aiandrobotics/fabrica/specs/reference-images/fabrica-architecture.png

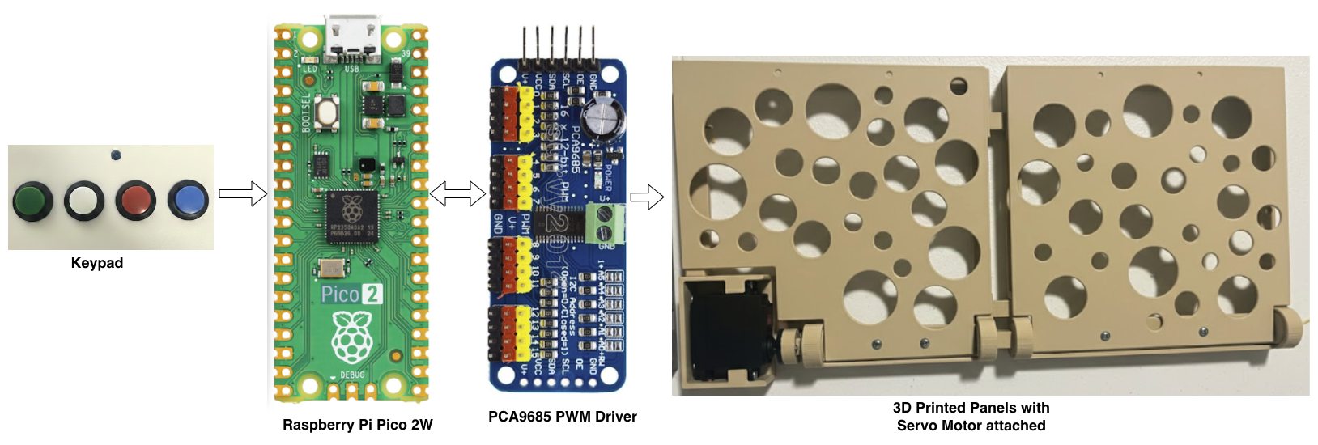
specs/reference-images/fabrica-architecture.png
