aiandrobotics/fabrica/specs/mission.md

# Fabrica - Cloth Folding Robot: Mission Specification

## Vision & Executive Summary

**Fabrica** is an open-source, end-to-end automated laundry folding system. The core mission of this project is to build and deliver a complete open-source hardware and software ecosystem—spanning **3D CAD designs**, **ESP32 firmware**, **a comprehensive documentation website**, and **a wireless mobile application**—that enables anyone to build, program, and operate a smart cloth folding robot for $80–$150.

Using a customizable grid of hinged 3D-printed panels and intelligent parallel servo motor actuation, Fabrica folds garments (such as t-shirts, towels, and trousers) in 8 to 12 seconds per item with a single button press or mobile app tap.

---

## Core Mission Deliverables

The Fabrica mission encompasses four primary, interconnected project deliverables:

1. **CAD Designs (`cad-designs/`)**:
   - Parametric 3D CAD models and STL/STEP export files for all modular panel types (Motorized, Follower, Base, Interface).
   - Engineered hinge linkages, drive shafts, servo couplers, and controller housing enclosures optimized for FDM 3D printing (PLA/PETG).

2. **Embedded Firmware (`firmware/`)**:
   - Production-grade C / FreeRTOS (ESP-IDF) firmware executing natively on the **ESP32**.
   - Driver integration for PCA9685 16-channel PWM servo driver over I2C, 4-button debounced interface, multi-pattern non-blocking status LED feedback, parallel and single motor step execution, non-volatile NVS flash sequence storage with IEEE 802.3 CRC32 protection, and factory default presets exercising all 4 folding flaps (Left, Right, Bottom, Top).

3. **Documentation Website (`docs/`)**:
   - A modern, interactive web-based documentation portal providing step-by-step 3D assembly guides, electrical wiring schematics, an interactive Bill of Materials (BOM), operation manuals, and troubleshooting flows.

4. **Mobile Application (`mobile-app/`)**:
   - The companion cross-platform mobile application is maintained in a dedicated external repository at **[https://github.com/aiandrobotics/air-robotics-app](https://github.com/aiandrobotics/air-robotics-app)**.
   - Provides wireless Bluetooth Low Energy (BLE) connectivity to the ESP32 firmware (`FAB0`–`FAB3` GATT services).
   - Enables visual sequence creation, button sequence configuration (Buttons 1–4), start/stop execution, real-time sequence progress and motor position monitoring, and client-side garment profile management.
   - The local `mobile-app/` directory serves as integration specifications, wire opcode documentation, and BLE protocol definitions.

---

## High-Level System Architecture

```mermaid
graph TD
    subgraph Deliverables Ecosystem
        CAD[CAD Designs<br/>cad-designs/]
        Docs[Docs Website<br/>docs/]
        Firmware[ESP32 Firmware<br/>firmware/]
        App[Mobile App<br/>mobile-app/]
    end

    User([User]) -->|Physical Buttons| Interface[Control Pad & LED]
    User -->|Wireless Control| App
    App -.->|Bluetooth LE (BLE)| Firmware
    Interface --> Firmware
    Firmware -->|I2C / PWM| Servos[Servo Motor Array]
    CAD -->|3D Printed Parts| Panels[Modular Panels & Frame]
    Servos --> Panels
    Docs -.->|Guides & Assembly| User
```

---

## Core Mission Pillars & System Goals

1. **Accessibility & Affordability**: Enable makers, STEM programs, and hobbyists to build a functional laundry robot for **$80–$150** using off-the-shelf components, standard 3D-printed parts, and affordable microcontrollers.
2. **Modular & Scalable Mechanical Design**: Support customizable grid arrangements (2×2, 4×3 standard, 4×4, 5×5, 6×6, or custom non-square layouts) supporting up to **16 motorized modules** paired with follower and base panels.
3. **Dual Operating Modes**: Standalone computer-free operation via physical button interface alongside full wireless control via the mobile application.
4. **Fluid Parallel Motion Execution**: Synchronized multi-motor execution allowing opposite panel flips to occur simultaneously, producing human-like motion and reducing cycle time by ~40%.
5. **Future AI Vision Expansion**: Camera-based fabric/garment vision recognition to automatically identify clothing types and suggest optimal folding parameters.

---

## Product Roadmap

- [x] **Deliverable 1: CAD Designs**: Modular 3D printed panel models, drive shafts, hinge links, controller housing, and full 4×3 grid assembly models.
- [x] **Deliverable 2: ESP32 Firmware (Core Engine & Presets)**: Embedded C/FreeRTOS firmware, PCA9685 I2C driver, 4-button debounced interface, status LED driver, parallel sequence executor, CRC32 NVS sequence manager, and 4 factory presets exercising all 4 flap motors (566/566 tests passing).
- [ ] **Deliverable 2b: Wireless BLE Mobile Integration**: Native NimBLE GATT services (`FAB1`, `FAB2`, `FAB3`), zero-bond indefinite auto-pairing & 120-second multi-device hold-to-pair window, and live telemetry.
- [ ] **Deliverable 3: Documentation Website**: Step-by-step mechanical assembly guides, wiring schematics, interactive BOM table, and user manuals.
- [ ] **Deliverable 4: Mobile Application**: Bluetooth Low Energy (BLE) wireless control, sequence configuration per button, start/stop execution, real-time motor progress streaming, and client-side garment profiles.
- [ ] **Future Expansion: AI Vision Recognition**: On-device or cloud-based AI garment classification from smartphone camera snapshot.

---

## Reference Visuals & Diagrams

The reference images located in [reference-images](./reference-images) document the system hardware, modules, and architecture:

- **System Overview & 3D Assembly**:
  - [3d-overview.png](./reference-images/3d-overview.png) - 3D CAD Overview of the assembled folding grid.
  - [fabrica-overview.png](./reference-images/fabrica-overview.png) - Assembled hardware unit overview.
  - [fabrica-architecture.png](./reference-images/fabrica-architecture.png) - Hardware and system architecture diagram.

- **Modular Components**:
  - [motorized-module.png](./reference-images/motorized-module.png) - Motorized module panel assembly with servo mount.
  - [follower-module.png](./reference-images/follower-module.png) - Passive follower hinged panel module.
  - [base-module.png](./reference-images/base-module.png) - Stationary structural base module.
  - [interface-module.png](./reference-images/interface-module.png) - Control pad and visual feedback interface module.

- **Controller**:
  - [rasberrypi-pico-2w.png](./reference-images/rasberrypi-pico-2w.png) - Microcontroller hardware reference.
