aiandrobotics/fabrica/specs/reference-images/3d-overview.png

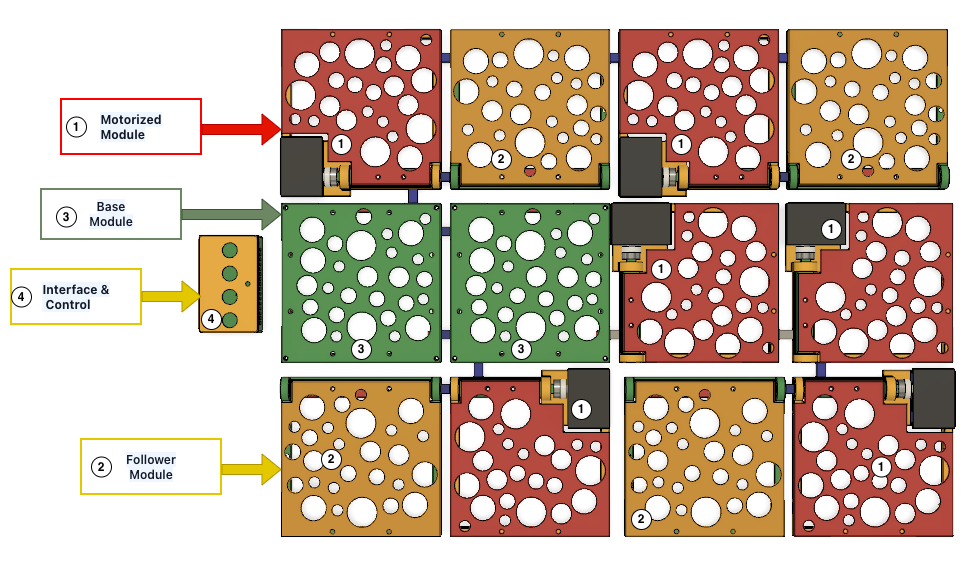
specs/reference-images/3d-overview.png
