aiandrobotics/fabrica/specs/reference-images/base-module.png

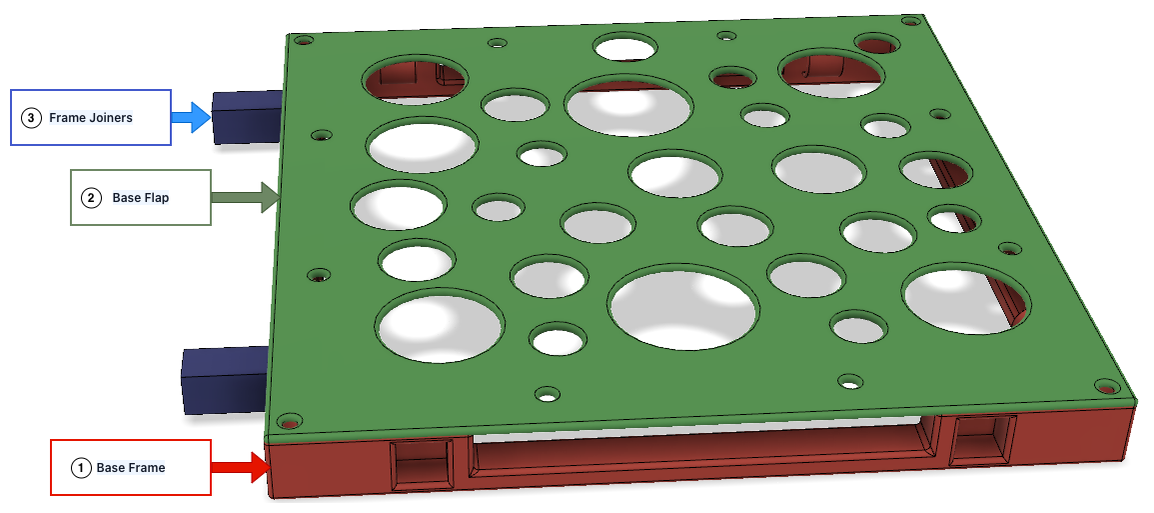
specs/reference-images/base-module.png
