aiandrobotics/fabrica/specs/reference-images/follower-module.png

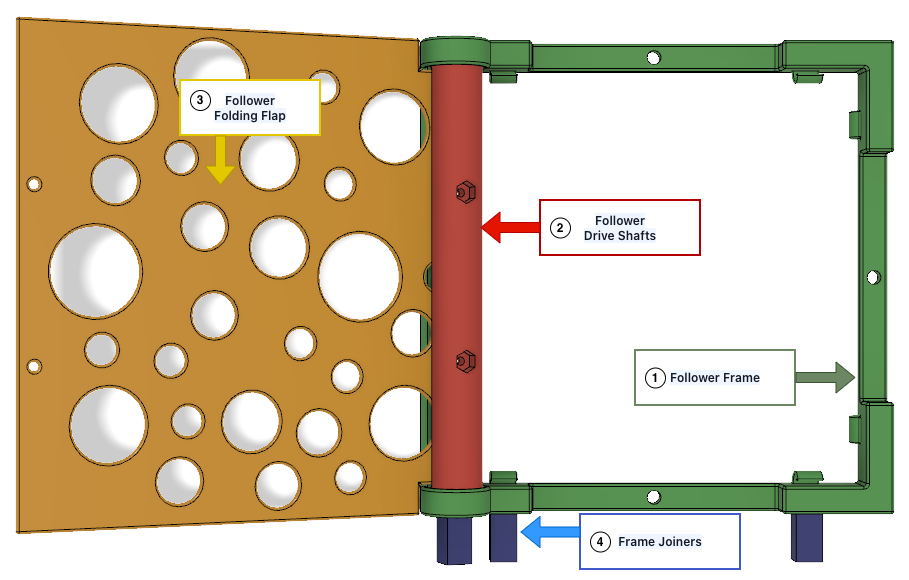
specs/reference-images/follower-module.png
