aiandrobotics/fabrica/specs/reference-images/interface-module.png

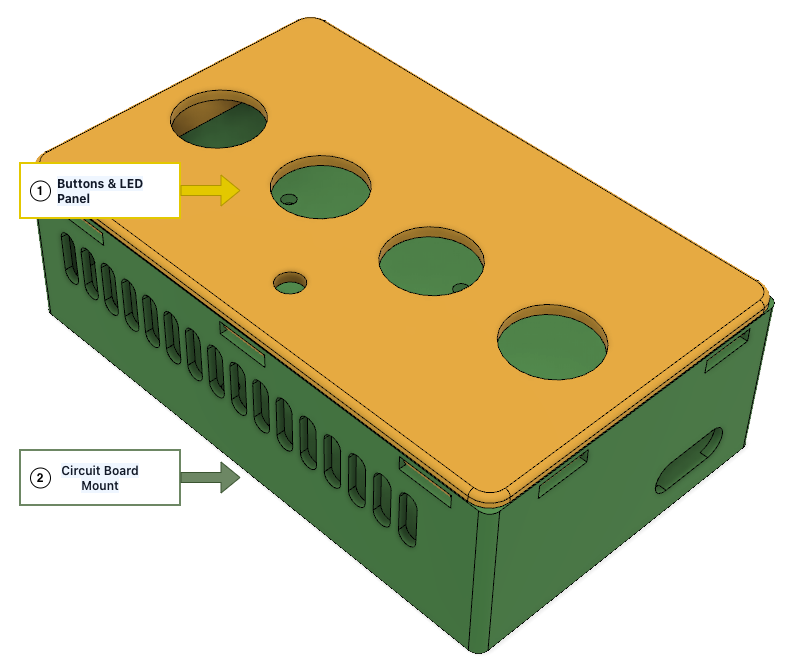
specs/reference-images/interface-module.png
