aiandrobotics/fabrica/specs/reference-images/mg996r-servo-dim.png

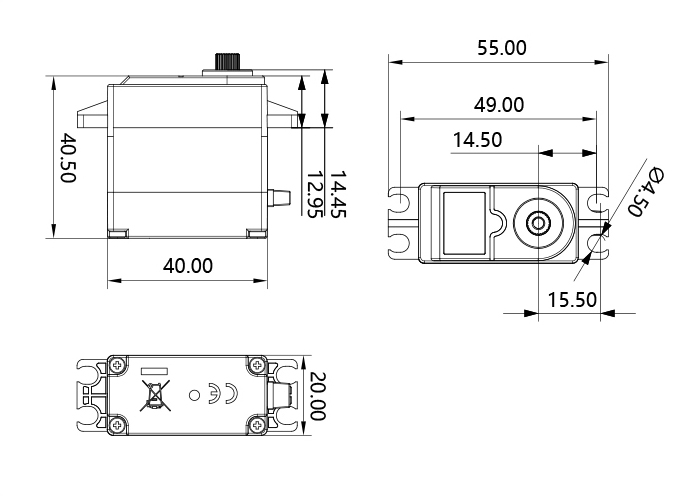
specs/reference-images/mg996r-servo-dim.png
