aiandrobotics/fabrica/specs/reference-images/mg996r-servo.png

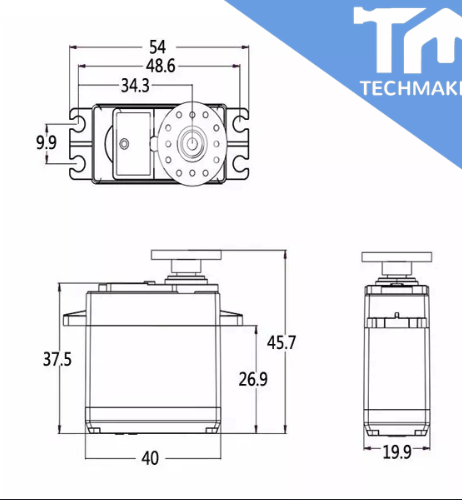
specs/reference-images/mg996r-servo.png
