aiandrobotics/fabrica/specs/reference-images/motorized-module.png

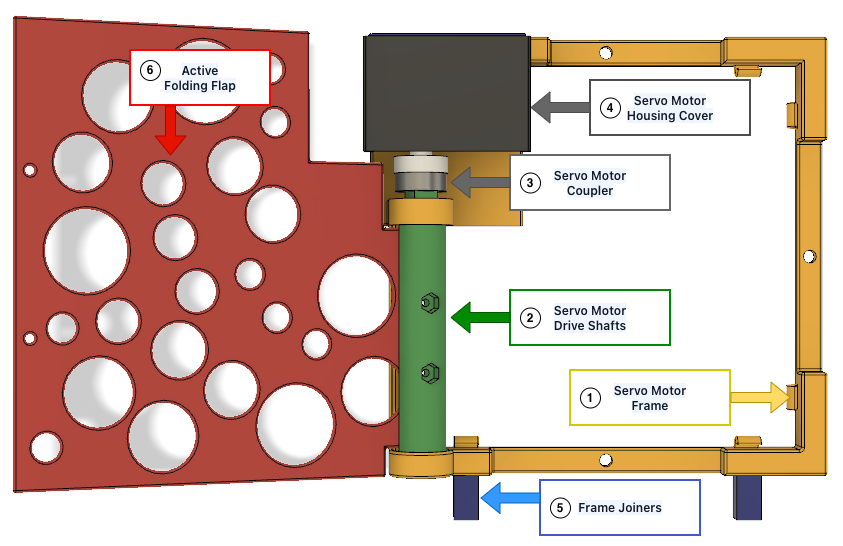
specs/reference-images/motorized-module.png
