aiandrobotics/fabrica/specs/reference-images/rasberrypi-pico-2w.png

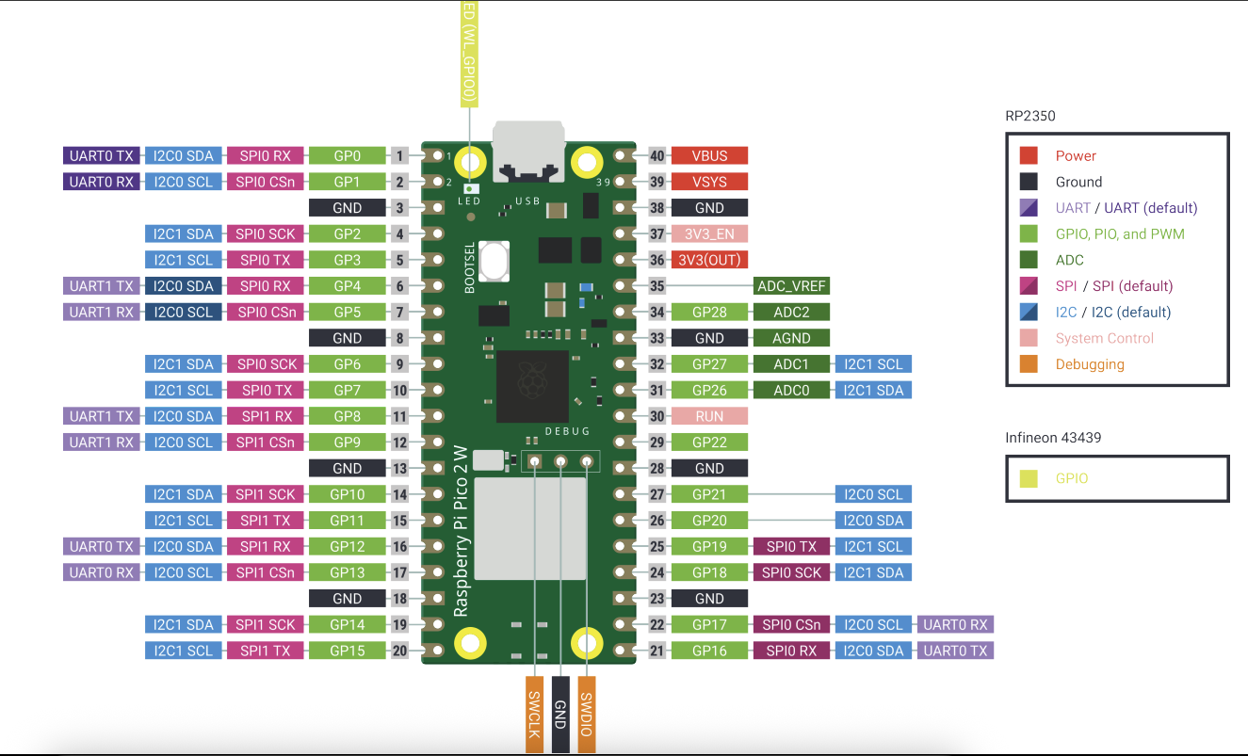
specs/reference-images/rasberrypi-pico-2w.png
