aiandrobotics/fabrica/cad-designs/exports/assembly.step

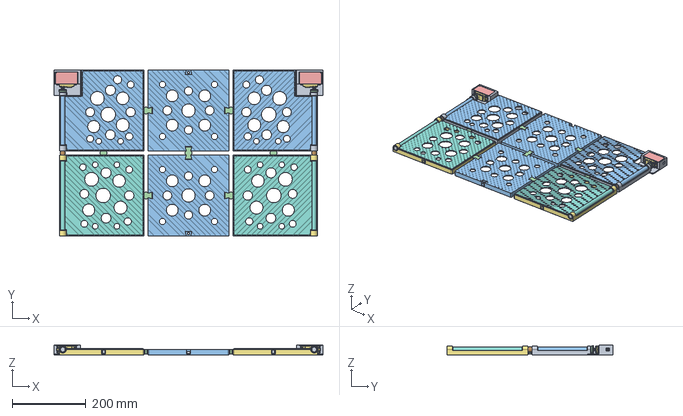
[picture p10: CAD file, 2026-11-06]
cad-designs/exports/assembly.step
728.0 x 450.0 x 27.2 mm
