aiandrobotics/fabrica/cad-designs/exports/follower_assembly.step

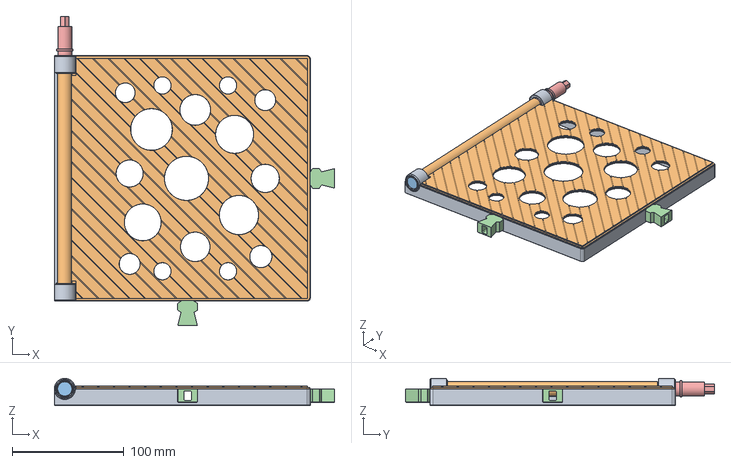
[picture p11: CAD file, 2026-11-06]
cad-designs/exports/follower_assembly.step
251.2 x 276.8 x 24.4 mm
