aiandrobotics/fabrica/cad-designs/exports/motorized_assembly.step

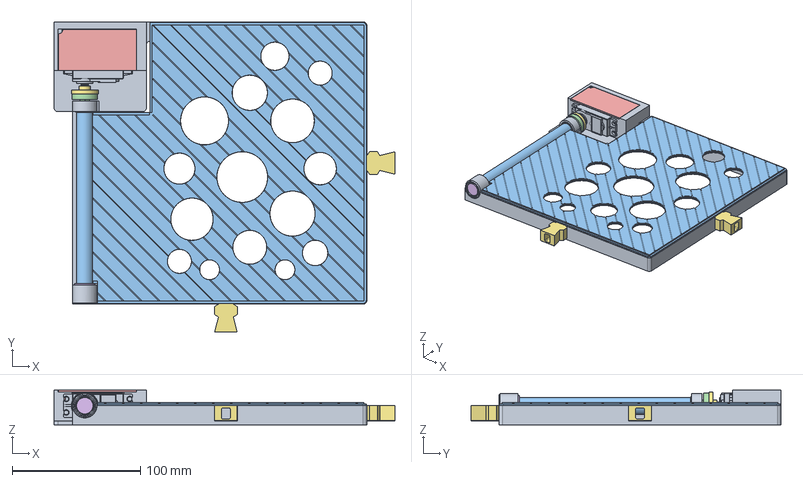
[picture p12: CAD file, 2026-11-06]
cad-designs/exports/motorized_assembly.step
265.8 x 241.8 x 27.2 mm
