aiandrobotics/fabrica/cad-designs/exports/interface_assembly.step

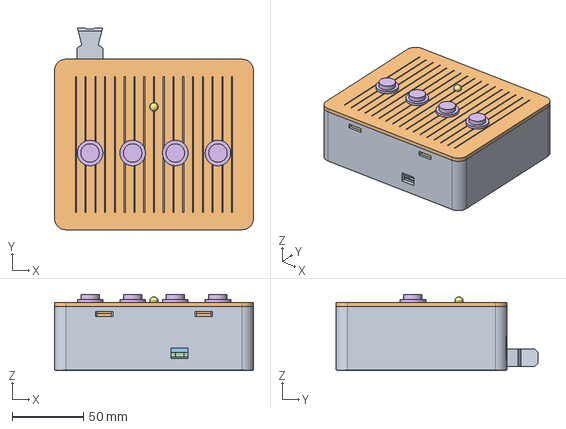
[picture p13: CAD file, 2026-11-06]
cad-designs/exports/interface_assembly.step
140.0 x 141.8 x 53.5 mm
