aiandrobotics/fabrica/cad-designs/3d-print/fabrica-bambu-lab-256.3mf

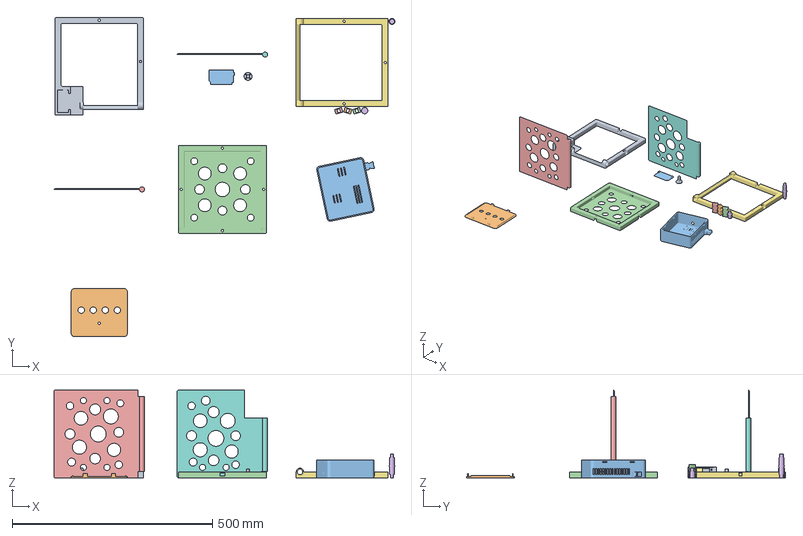
[picture p14: CAD file, 2026-11-08]
cad-designs/3d-print/fabrica-bambu-lab-256.3mf
850.5 x 796.4 x 219.0 mm
