aiandrobotics/fabrica/cad-designs/exports/motorized_servo_cover.step

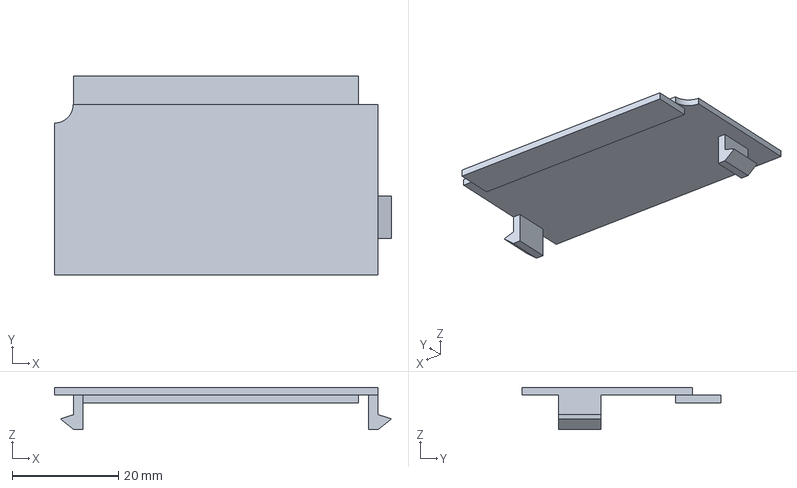
[picture p15: CAD file, 2026-11-06]
cad-designs/exports/motorized_servo_cover.step
63.3 x 37.3 x 7.90 mm
