aiandrobotics/fabrica/cad-designs/3d-print/MG996R.step

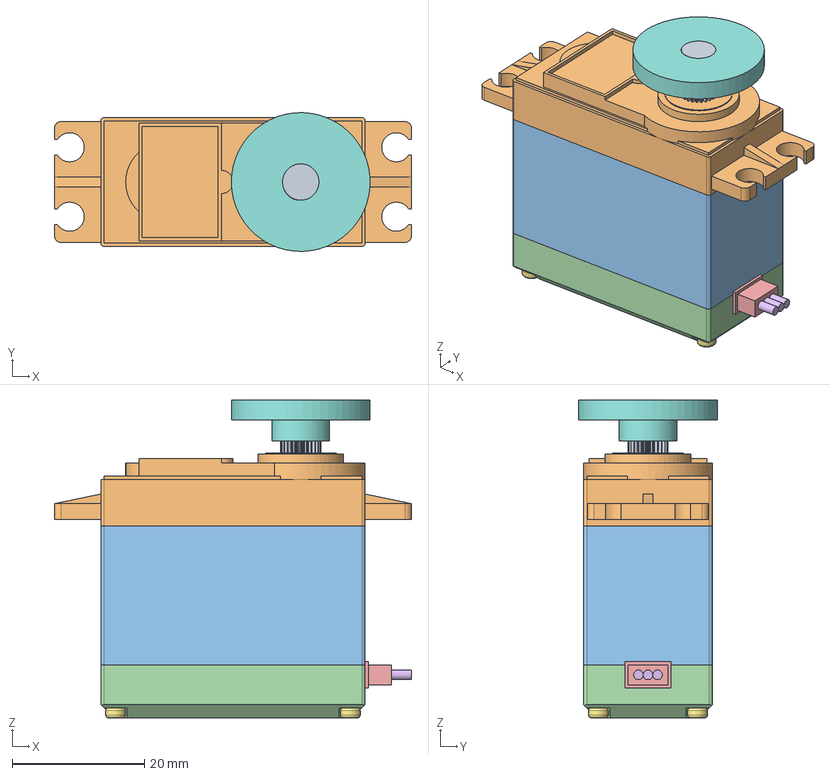
[picture p16: CAD file, 2026-08-18]
cad-designs/3d-print/MG996R.step
54.0 x 21.0 x 48.0 mm
Spur Gear (25 teeth)
mg996r-circular-connector
