aiandrobotics/fabrica/cad-designs/exports/interface_panel.step

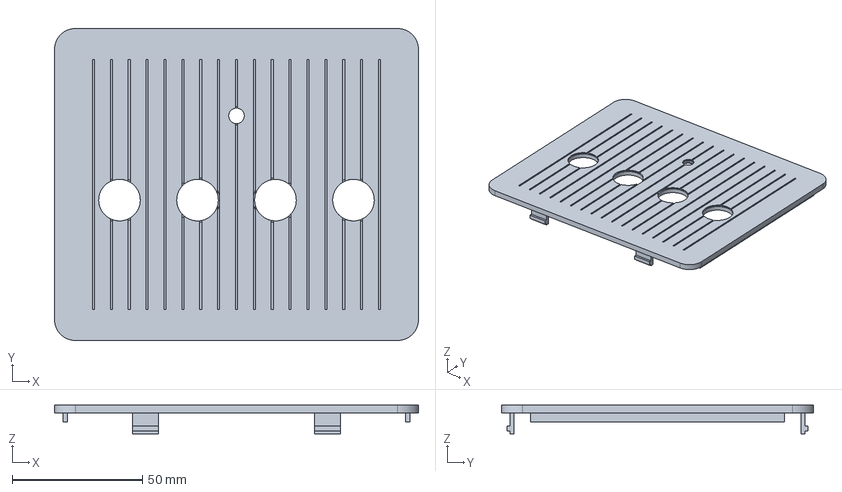
[picture p17: CAD file, 2026-11-06]
cad-designs/exports/interface_panel.step
140.0 x 120.0 x 11.0 mm
