aiandrobotics/fabrica/cad-designs/exports/interface_case.step

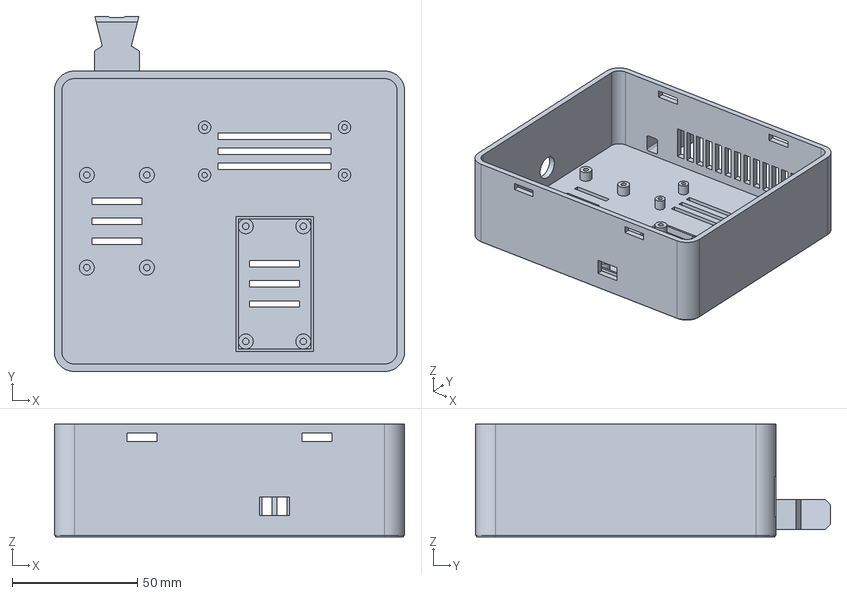
[picture p19: CAD file, 2026-11-06]
cad-designs/exports/interface_case.step
140.0 x 141.8 x 45.0 mm
