aiandrobotics/fabrica/cad-designs/exports/end_pivot_pin.step

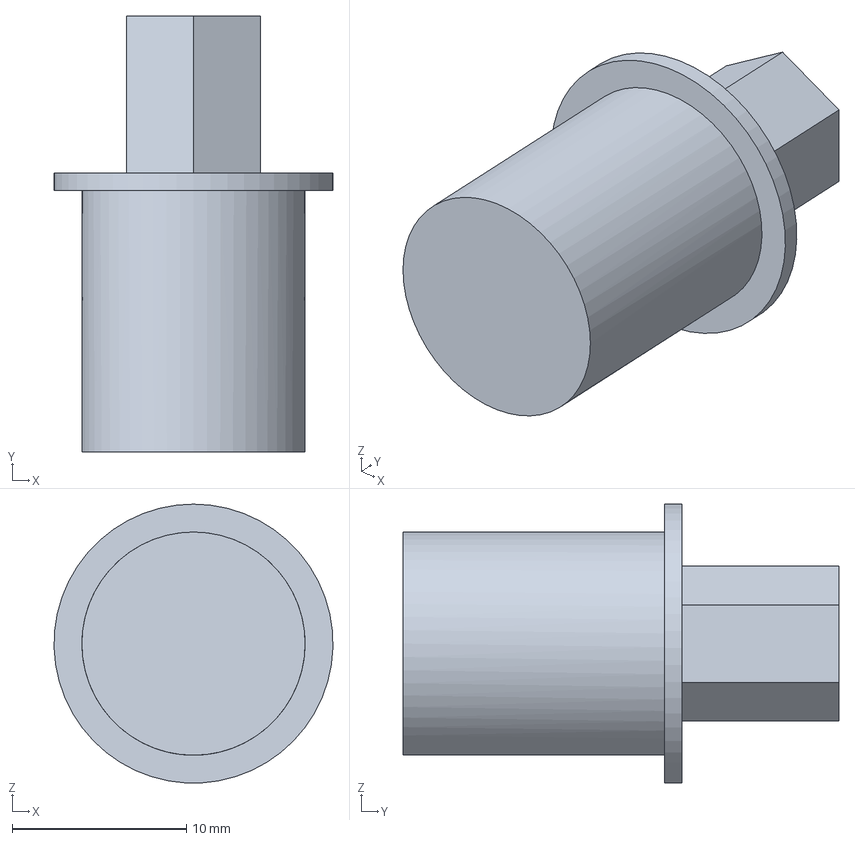
[picture p20: CAD file, 2026-11-06]
cad-designs/exports/end_pivot_pin.step
16.0 x 25.0 x 16.0 mm
