aiandrobotics/fabrica/cad-designs/exports/frame_joiner.step

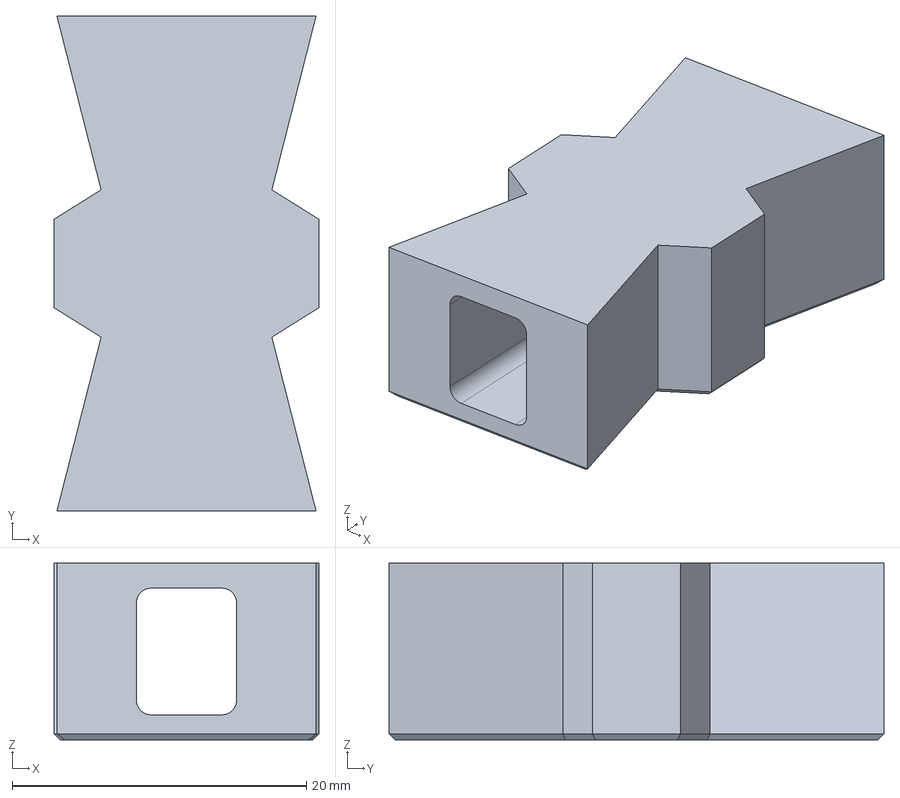
[picture p21: CAD file, 2026-11-06]
cad-designs/exports/frame_joiner.step
18.0 x 33.6 x 12.0 mm
