aiandrobotics/fabrica/cad-designs/exports/motorized_servo_adapter.step

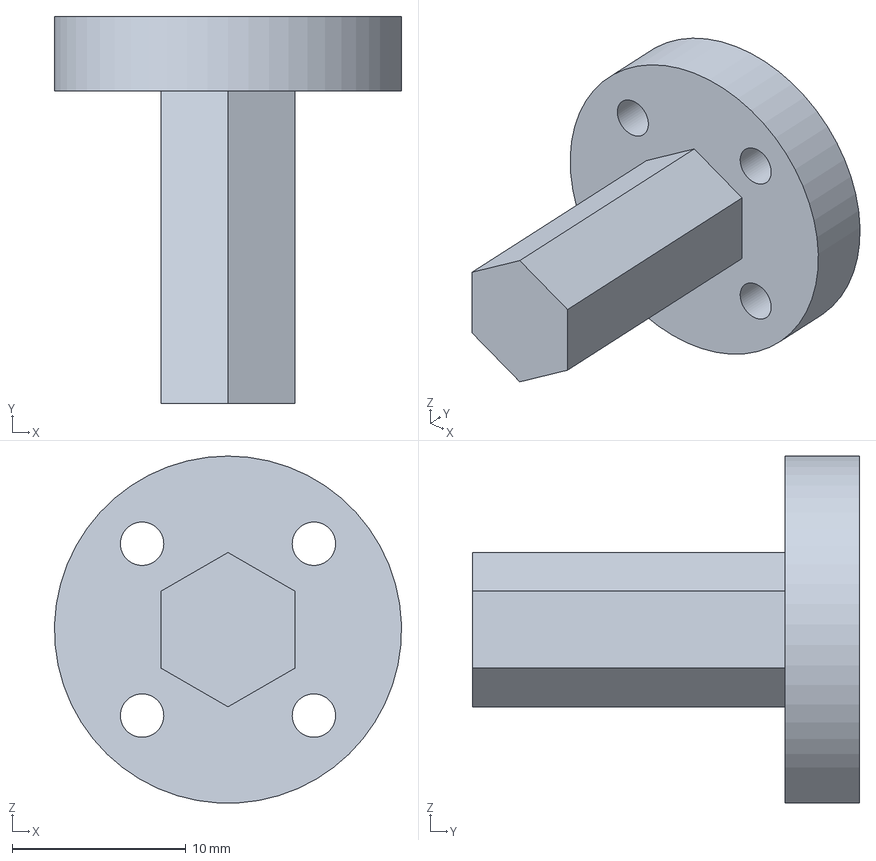
[picture p22: CAD file, 2026-11-06]
cad-designs/exports/motorized_servo_adapter.step
20.0 x 22.3 x 20.0 mm
