aiandrobotics/fabrica/cad-designs/exports/motorized_frame.step

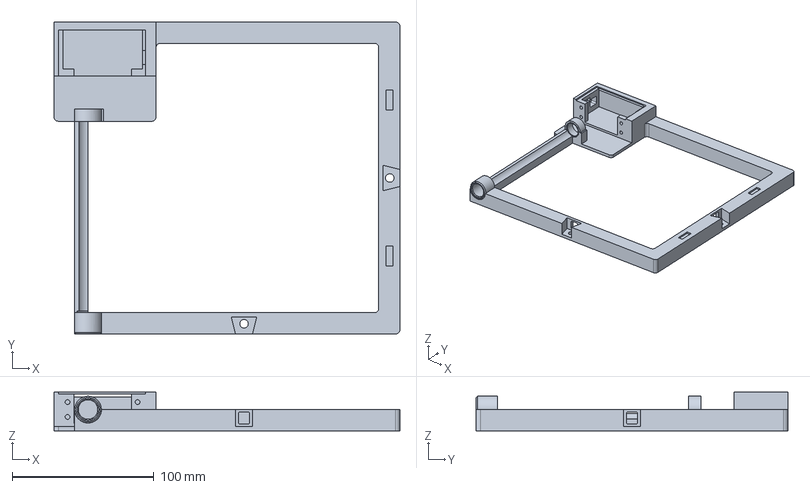
[picture p23: CAD file, 2026-11-06]
cad-designs/exports/motorized_frame.step
244.0 x 220.0 x 27.2 mm
