aiandrobotics/fabrica/cad-designs/exports/hex_drive_coupler.step

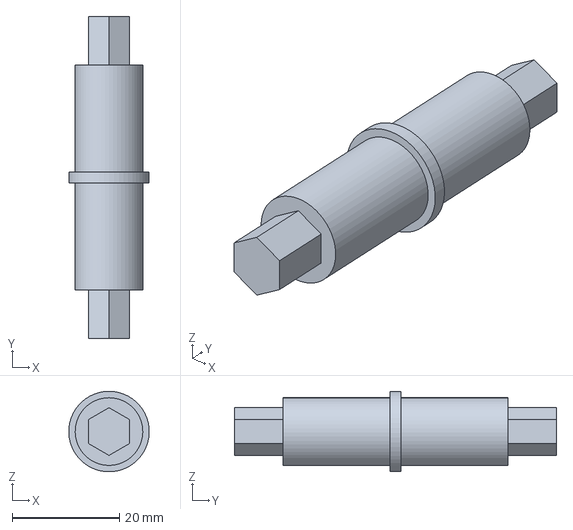
[picture p24: CAD file, 2026-11-06]
cad-designs/exports/hex_drive_coupler.step
15.0 x 60.0 x 15.0 mm
