aiandrobotics/fabrica/cad-designs/exports/follower_frame.step

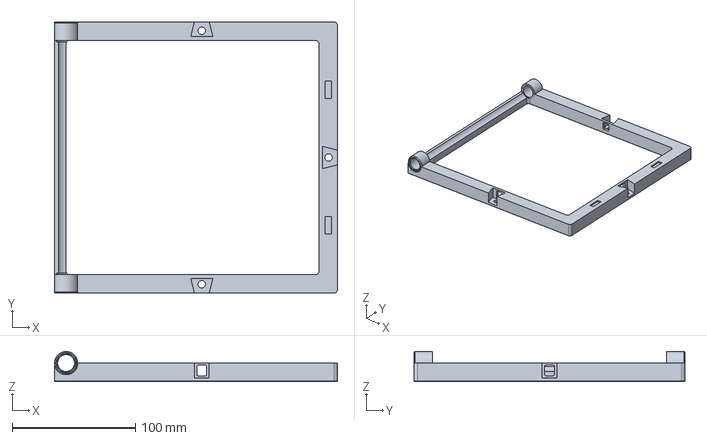
[picture p25: CAD file, 2026-11-06]
cad-designs/exports/follower_frame.step
229.4 x 220.0 x 24.4 mm
