aiandrobotics/fabrica/cad-designs/exports/base_module.step

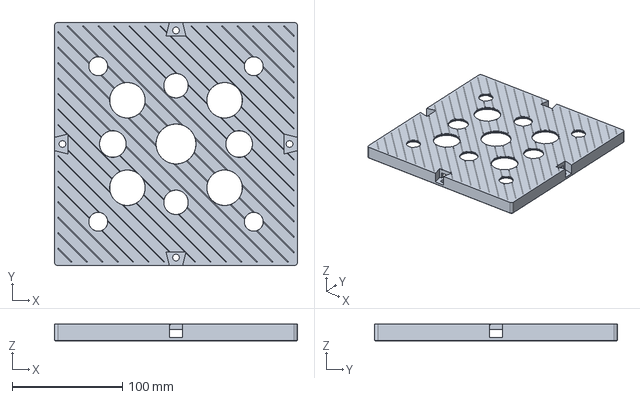
[picture p26: CAD file, 2026-11-06]
cad-designs/exports/base_module.step
220.0 x 220.0 x 15.0 mm
