aiandrobotics/fabrica/cad-designs/exports/motorized_flap.step

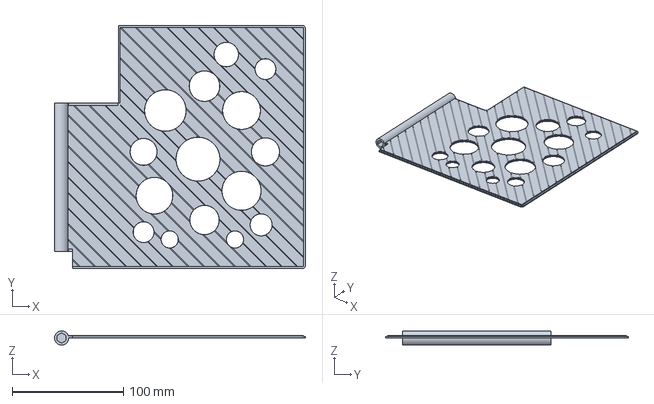
[picture p27: CAD file, 2026-11-06]
cad-designs/exports/motorized_flap.step
225.9 x 219.0 x 12.8 mm
