aiandrobotics/fabrica/(list of files, cad)

Other CAD files:
cad-designs/exports/base_module.stl
cad-designs/exports/end_pivot_pin.stl
cad-designs/exports/follower_flap.stl
cad-designs/exports/follower_frame.stl
cad-designs/exports/frame_joiner.stl
cad-designs/exports/hex_drive_coupler.stl
cad-designs/exports/interface_case.stl
cad-designs/exports/interface_panel.stl
cad-designs/exports/motorized_flap.stl
cad-designs/exports/motorized_frame.stl
cad-designs/exports/motorized_servo_adapter.stl
cad-designs/exports/motorized_servo_cover.stl
