aiandrobotics/fabrica/specs/reference-images/fabrica-overview.png

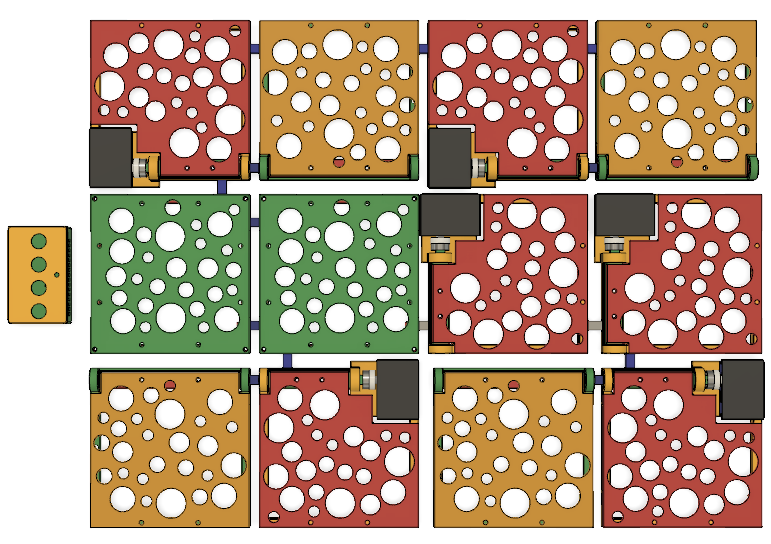
specs/reference-images/fabrica-overview.png
