aiandrobotics/fabrica/firmware/specs/2026-08-26-phase-2-ui-subsystem/validation.md

# Validation — Phase 2: UI Subsystem (4-Button Debouncer & Non-Blocking LED Pattern Engine)

## Required Checks

### 1. Host-Based Unit Test Suite (`firmware/test/test_ui_subsystem.c`)
- [ ] Compile and execute host test harness using GCC or Clang:
  ```bash
  gcc -Wall -Wextra -Werror -I./firmware/main -o /tmp/test_ui_subsystem firmware/test/test_ui_subsystem.c && /tmp/test_ui_subsystem
  ```
- [ ] **Debounce Filter Validation**:
  - Verify spurious noise spikes (<50ms) on any button GPIO do not transition button state or dispatch commands.
  - Verify stable low level maintained for ≥50ms transitions state to pressed.
- [ ] **Short Tap Gesture Validation**:
  - Simulate press duration of 150ms on B1 $\rightarrow$ verify exact generation of `CMD_RUN_PRESET` with `preset_id = 1` and `source = SOURCE_PHYSICAL_BUTTON`.
  - Simulate press duration of 250ms on B2, B3, B4 $\rightarrow$ verify exact generation of `CMD_RUN_PRESET` with `preset_id = 2, 3, 4`.
- [ ] **Long Press Gesture Validation**:
  - Simulate continuous press for 3000ms on B1 $\rightarrow$ verify generation of `CMD_ENTER_PROGRAM_MODE` with `preset_id = 1` at exactly the 3000ms mark.
  - Verify that subsequent button release (e.g. at 3500ms) produces zero extra commands.
- [ ] **LED Pattern Sequencer Validation**:
  - Test `LED_STATE_IDLE`: verifies 100ms ON / 1900ms OFF repeating timing.
  - Test `LED_STATE_RUNNING`: verifies continuous 100% duty cycle ON.
  - Test `LED_STATE_PROGRAMMING`: verifies 1000ms ON / 1000ms OFF repeating timing.
  - Test `LED_STATE_STEP_LOCKED`: verifies exactly 2 pulses of 80ms ON / 80ms OFF, then returns to previous base state.
  - Test `LED_STATE_SAVE_SUCCESS`: verifies solid ON for 2000ms, then returns to `LED_STATE_IDLE`.
  - Test `LED_STATE_INPUT_ERROR`: verifies exactly 3 pulses of 60ms ON / 60ms OFF, then returns to previous base state.
  - Test `LED_STATE_ESTOP`: verifies exactly 5 pulses of 50ms ON / 50ms OFF, then returns to `LED_STATE_IDLE`.

### 2. ESP-IDF Build & Compilation Verification
- [ ] Confirm `CMakeLists.txt` registers `led.c` and `buttons.c`.
- [ ] Execute clean ESP-IDF project compilation:
  ```bash
  idf.py build
  ```
- [ ] Verify compilation completes with **0 warnings** and **0 errors** under `-Wall -Wextra`.
- [ ] Verify binary size and SRAM allocation leave $\ge 120\text{ KB}$ internal DRAM available for future phases.

---

## Manual Review & Hardware Bench Verification

### 1. Serial Monitor Logging Inspection
- [ ] Flash ESP32 Dev Board and connect monitor:
  ```bash
  idf.py flash monitor
  ```
- [ ] Verify boot diagnostics show `app_ui_task` (Core 1, Priority 5) and `app_led_task` (Core 1, Priority 3) running.
- [ ] **Short Tap Test**:
  - Briefly tap B1 $\rightarrow$ verify log: `[BUTTONS] Button B1 Short Tap (<500ms) -> Dispatched CMD_RUN_PRESET (Preset 1)`.
  - Briefly tap B2, B3, B4 $\rightarrow$ verify logs for Presets 2, 3, and 4.
- [ ] **Long Press Test**:
  - Hold B1 for 3 seconds $\rightarrow$ verify log at 3s mark: `[BUTTONS] Button B1 Long Press (>=3000ms) -> Dispatched CMD_ENTER_PROGRAM_MODE (Preset 1)`.
  - Release B1 after 4s $\rightarrow$ verify no trailing tap message logged.

### 2. Physical Status LED Inspection
- [ ] Observe on-board LED (`GPIO 2`) during idle: soft heartbeat (100ms pulse every 2 seconds).
- [ ] Trigger test states and confirm visual output matches specified blink timings (slow blink in program mode, rapid 5-flash on E-stop, solid ON for save confirmation).

---

## Merge Criteria

- [ ] All three spec documents (`plan.md`, `requirements.md`, `validation.md`) are created in `firmware/specs/2026-08-26-phase-2-ui-subsystem/`.
- [ ] Working branch `feature/phase-2-ui-subsystem` is active.
- [ ] Spec aligns completely with `specs/mission.md`, `specs/tech-stack.md`, and `specs/roadmap.md`.
- [ ] No implementation code was written during the spec authoring stage.
