aiandrobotics/fabrica/CHANGELOG.md

# Changelog

## 2026-11-12
- Implemented Full Factory Reset (`CMD_FACTORY_RESET_ALL`):
  - Physical gesture: Holding B1 + B3 + B4 simultaneously for 10 seconds (`BUTTON_FACTORY_RESET_MS = 10000`) wipes both custom folding routines in NVS back to factory defaults and all stored BLE bonds, homes all 16 servos to 0°, terminates active central connections, and restarts into indefinite pairing mode (`LED_STATE_BLE_PAIRING`).
  - Wireless command: Added BLE Opcode `0x1F` (`BLE_OP_FACTORY_RESET_ALL`) on `FAB1` Control Point to trigger a full wipe remotely.
  - Added test coverage in `test_headers.c`, `test_ui_subsystem.c`, `test_state_machine.c`, and `test_ble_integration.c` (98/98 checks passing).
  - Updated all technical specs, architecture docs, and README cheat sheets.
- Updated zero-bond BLE pairing behavior: pairing mode now remains open indefinitely on initial boot and post-wipe when 0 devices are bonded in NVS until the first central pairs.
- Preserved the 120-second timed pairing window for multi-device pairing (2nd through 4th central) entered via 3-second physical button hold (`CMD_ENTER_BLE_PAIRING`).
- Updated specifications, test suites (`test_state_machine.c`, `test_ble_integration.c`), and README pairing walkthrough.

## 2026-11-11
- Implemented zero-bond out-of-the-box auto-pairing in `firmware/main/state_machine.c` and `firmware/main/main.c`: when zero devices are bonded in NVS (brand new device or post-factory reset), Fabrica automatically starts the 120-second BLE pairing window on boot/reset without requiring a 3-second button hold.
- Automatically re-opened the 120-second BLE pairing window following a hardware bond reset (`CMD_CLEAR_BLE_BONDS`, `B1+B4` 5s chord hold) while confirming with transient `LED_STATE_INPUT_ERROR` flashes.
- Guaranteed the 3-second physical button hold (`CMD_ENTER_BLE_PAIRING`) remains active unconditionally on new/0-bond devices to allow refreshing the 120s pairing window timer or re-opening after timeout.
- Updated all firmware specifications, requirements, validation docs, and README.md pairing walkthroughs.
- Expanded host integration tests in `test/test_state_machine.c` and `test/test_ble_integration.c` verifying zero-bond auto-pairing, 3s hold timer refresh, timeout rejection, and post-wipe re-opening.
- Fixed BLE auto-reconnection for bonded iOS and Android centrals using Resolvable Private Addresses (RPAs) in `firmware/main/ble_transport.c`.
- Integrated `ble_gap_rpa_resolve()` from `<host/ble_esp_gap.h>` to cryptographically resolve rotating RPAs against stored Identity Resolving Keys (IRKs) in NVS.
- Checked both `peer_id_addr` and `peer_ota_addr` in `ble_gap_event_handler()` to eliminate premature link rejection outside the Hold-to-Pair window.

## 2026-11-10
- Added comprehensive root `README.md` covering system architecture, CAD designs, embedded firmware, mobile application integration, electrical schematics, Bill of Materials, and quick start guide.
- Updated `mobile-app/README.md`, `docs/README.md`, and `specs/mission.md` to reference the dedicated companion mobile application repository (`https://github.com/aiandrobotics/air-robotics-app`).

## 2026-11-08
- Replaced system-specific paths, macOS application bundle locations, and absolute user URIs with generic, cross-platform paths and relative links across CAD scripts, tooling, and firmware specifications.
- Implemented Phase 11 End-to-End Firmware BLE Validation & App Store Test App Playbook (`firmware/test/test_ble_integration.c`, `firmware/README.md`, `firmware/Makefile`).
- Created automated dual-OS mock BLE central simulation test harness (`test_ble_integration.c`) modeling iOS `CoreBluetooth` (185B MTU, peripheral security request, RPA resolution) and Android `BluetoothGatt` (legacy 23B MTU, Long Read `ATT_READ_BLOB_REQ` fallback).
- Implemented 17 end-to-end integration protocol verification vectors covering advertising split, DIS, Apple connection parameter compliance, Hold-to-Pair security, locator pulse train, preset table read/write/notify, compact sequence recipes, raw sequence preview, busy locks, 10 Hz/1 Hz telemetry, live servo jog calibration, fast-path E-Stop, and factory restore.
- Verified multi-source concurrency arbitration, abrupt BLE disconnect safety, and 200-cycle continuous automated fold endurance stress test with zero memory leaks and invariant stability.
- Documented exhaustive App Store BLE test app playbook in `firmware/README.md` with complete characteristic UUID tables, step-by-step pairing walkthroughs, ready-to-paste hexadecimal command cheat sheets (`0x00–0x11`), and 31-byte telemetry decoding guide for **nRF Connect for Mobile** and **LightBlue** on iOS and Android.
- Added Phase 11 feature specification directory (`firmware/specs/2026-11-08-phase-11-e2e-ble-validation-playbook/`) with `plan.md`, `requirements.md`, and `validation.md`.
- Achieved 78/78 passing checks in `test_ble_integration.c` (**911/911 checks passing across all 11 test suites** with `-Wall -Wextra -Werror`) and clean ESP-IDF v6.0.2 target builds (`idf.py build`, 51% flash free).
- Updated `firmware/specs/roadmap.md` marking Phase 11 complete (`✅`).
- Implemented Phase 10 Real-Time Telemetry & Button Configuration Sync (`firmware/main/telemetry.h`, `firmware/main/telemetry.c`, `firmware/main/motion.h`, `firmware/main/motion.c`, `firmware/main/main.c`, `firmware/main/config.h`).
- Added adaptive FreeRTOS background streaming task (`app_telem_task`, Core 1, Priority 3) running high-rate 10 Hz (100ms) telemetry streaming during motion (`STATE_RUNNING_MOTION`) and calibration (`STATE_CALIBRATING`), adaptively throttling to low-rate 1 Hz (1000ms) when idle, E-stopped, or in error.
- Implemented live mid-sweep elapsed time (`elapsed_step_time_ms`) and progress percentage (`step_progress_pct`, 0–100%) tracking across folding sweeps and dwells in `motion.c`, exposed via `motion_get_progress()`.
- Implemented stream pause/resume via Opcode `0x11` (`CMD_SET_TELEMETRY_STREAM`), CCCD subscription gating on `FAB2`, and immediate fail-safe stream muting upon central disconnection.
- Integrated `FAB3` 212-byte button configuration synchronization notifications on sequence modification and on-demand query (`CMD_SYNC_PRESETS`, `0x0B`).
- Added Phase 10 feature specification directory (`firmware/specs/2026-11-08-phase-10-real-time-telemetry-sync/`) with `plan.md`, `requirements.md`, and `validation.md`.
- Added Phase 10 host unit test suite (`firmware/test/test_telemetry.c`), passing 70/70 checks (833/833 checks passing across all 10 test suites with `-Wall -Wextra -Werror`) and clean ESP-IDF v6.0.2 target builds (`idf.py build`, 51% flash free).
- Updated `firmware/specs/roadmap.md` marking Phase 10 complete.
- Implemented Phase 9 BLE Command Dispatch, Remote Execution & Servo Calibration (`firmware/main/remote_cmd.h`, `firmware/main/remote_cmd.c`, `firmware/main/state_machine.h`, `firmware/main/state_machine.c`).
- Extracted `FAB1` / `FAB3` wire command validation, compact routine unpacking, Core 1 fast-path preemption, and command status code reflection into a dedicated `remote_cmd.c` module.
- Added stateless raw routine execution (`CMD_RUN_RAW_SEQUENCE`, `0x01`) supporting full 54-byte and compact variable-length payloads with zero-padding and IEEE 802.3 CRC32 calculation, leaving NVS presets untouched.
- Implemented ingress busy re-entrancy protection, empty preset validation (`CMD_STATUS_ERR_INVALID_STEP`), and dedicated 100% routine completion notifications on `FAB2` (`step_progress_pct = 100`, `CMD_STATUS_OK`).
- Implemented latched Emergency Stop (`STATE_ESTOP`, `system_state = 2`, `error_code` `BIT2` active) with `<50ms` Core 1 preemption, requiring `CMD_STOP_SEQUENCE` (`0x02`) over BLE or a physical button tap to clear back to `STATE_IDLE_RUN`.
- Added interactive servo jog calibration (`STATE_CALIBRATING`, `0x0D`), motor/angle bounds validation (`CMD_STATUS_ERR_MOTOR_BOUNDS`), 10-second PCA9685 oscillator sleep thermal cutoff (`CALIBRATION_THERMAL_TIMEOUT_MS`), automatic wake-on-jog, and 15-second inactivity auto-home watchdog (`CALIBRATION_INACTIVITY_TIMEOUT_MS`) with immediate fail-safe exits on BLE disconnect or button tap.
- Added Phase 9 feature specs (`firmware/specs/2026-11-07-phase-9-ble-command-dispatch-calibration/`) and dedicated host unit test suite (`firmware/test/test_remote_cmd.c`), achieving 763/763 passing checks across all 9 test suites and clean ESP-IDF v6.0.2 target builds.
- Updated `specs/roadmap.md` marking Phase 9 complete.

## 2026-11-07
- Implemented Phase 8 Apache NimBLE GATT Server on Core 1 (`firmware/main/ble_transport.h`, `firmware/main/ble_transport.c`) with native iOS (`CoreBluetooth`) and Android (`BluetoothGatt`) interoperability for off-the-shelf BLE scanner apps.
- Added split 31-byte-compliant GAP advertising (`0000FAB0-...` 128-bit UUID in primary advertisement and dynamic `Fabrica-XXXX` MAC-derived name in scan response), peripheral-initiated 512-byte ATT MTU negotiation, and 15ms–30ms connection parameter requests.
- Implemented 3-second physical button hold-to-pair security (`CMD_ENTER_BLE_PAIRING`, 120s window) with priority active-central preemption, native SMP "Just Works" LE Secure Connections bonding with IRK/RPA resolution, 4-bond NVS FIFO eviction, and `B1 + B4` 5-second chord bond factory reset (`CMD_CLEAR_BLE_BONDS`).
- Registered Device Information Service (`0x180A`) and custom Fabrica service (`FAB0`) exposing `FAB1` Control Point, `FAB2` 31-byte packed telemetry, and `FAB3` 212-byte packed 4-button sequence table with `0x2901` User Description labels, compact/full sequence writes, and automatic IEEE 802.3 CRC32 calculation.
- Simplified status LED state machine to automatic state-driven patterns (`LED_STATE_BLE_CONNECTED`, `LED_STATE_IDENTIFY`) and decoupled `CMD_STOP_SEQUENCE` from closing active BLE pairing windows.
- Added Phase 8 feature specifications and host unit test suite (`firmware/test/test_ble_transport.c`) achieving 681/681 checks passing across all 8 suites, verified on physical ESP32 hardware over BLE.

## 2026-11-06
- Aligned firmware state machine and 4-button UI subsystem with BLE-centric architecture (`firmware/main/state_machine.c`, `firmware/main/buttons.c`).
- Updated factory default presets 1–4 in `firmware/main/storage.c` to exercise all 4 flap motors including the top collar channel.
- Tracked and exported CAD STEP models, printable STL files, and updated Bambu Studio 3MF project files.
- Refined BLE firmware roadmap and specifications for zero-custom-app iOS and Android scanner interoperability.

## 2026-09-14
- Updated BLE firmware specifications with cross-platform iOS and Android mobile app requirements (`mission.md`, `tech-stack.md`, `roadmap.md`).
- Split BLE advertising payload to fit 31-byte legacy limit with 128-bit Service UUID in primary advertisement for iOS background scanning and device name in scan response.
- Configured low-latency connection parameters (15ms-30ms) compliant with Apple Bluetooth Accessory Design Guidelines.
- Added adaptive telemetry streaming (10 Hz in active motion, 1 Hz when idle) to conserve mobile battery and eliminate iOS background throttling.
- Defined dual-mode GATT write semantics (`Write Without Response` for time-critical commands, `Write With Response` for sequence/NVS commits).
- Added Resolvable Private Address (RPA) privacy handling and Little-Endian wire encoding standards across telemetry and sequence data structures.

## 2026-09-07
- Updated firmware specifications (`mission.md`, `tech-stack.md`, `roadmap.md`) establishing complete BLE mobile app integration requirements across execution, control, button configuration, and visual feedback.
- Defined packed binary wire framing protocol on Control Point (`FAB1`) with standardized opcodes for remote execution, calibration jogging, robot identification, and LED modes.
- Added re-entrancy protection, empty preset validation, active motion sequence write locks, integer motor jog lifecycle with thermal cutoffs, and 1:1 mobile UI status mirroring via 30-byte telemetry.
- Implemented Phase 7 End-to-End System Validation, Stress Testing & Preset Library (`firmware/`).
- Standardized factory preset library in `firmware/main/storage.c` for 4 garment profiles (Adult T-Shirt, Long-Sleeve Shirt, Trousers/Jeans, Towel/Linen).
- Defined physical servo flap channel constants in `firmware/main/config.h` (`SERVO_FLAP_LEFT`, `SERVO_FLAP_RIGHT`, `SERVO_FLAP_BOTTOM`, `SERVO_FLAP_TOP`).
- Created dedicated end-to-end stress and endurance test suite in `firmware/test/test_e2e_stress.c`.
- Verified 100-cycle continuous routine execution with zero memory leaks and steady heap stability.
- Validated mid-sweep Emergency Stop preemption across all motion phases with <50ms abort latency and immediate 16-channel homing flat to 0 degrees.
- Verified NVS flash power-loss and bit-rot resilience with automatic CRC32 corruption detection and safe fallback to default factory routines.
- Tested 50 rapid mode-switching stress cycles verifying state machine invariant stability.
- Registered `test_e2e_stress` in `firmware/Makefile`, achieving 553/553 checks passing across all 7 test suites.
- Rewrote `firmware/README.md` into a comprehensive system guide covering wiring schematics, power isolation, dual-core architecture, and operator manual.
- Updated firmware roadmap marking Phase 7 as complete.

## 2026-08-27
- Implemented Phase 6 Visual Staging Programming Mode & State Machine Integration (`firmware/main/state_machine.h`, `firmware/main/state_machine.c`).
- Built central State Machine engine coordinating 3 primary system operating states (`STATE_IDLE_RUN`, `STATE_RUNNING_MOTION`, `STATE_PROGRAMMING`).
- Implemented computer-free Visual Staging workflow:
  - Long press ($\ge 3\text{s}$) on B1–B4 enters Programming Mode for that target preset; Status LED transitions to `LED_STATE_PROGRAMMING` (0.5 Hz slow blink) and all servos home flat to $0^\circ$.
  - B1 (CYCLE / NUDGE): Increment servo cursor across channels 0–15 with wrap-around and trigger physical $15^\circ$ identification pulse (`NUDGE_ANGLE_DEG`) via `pca9685_nudge_channel()`.
  - B2 (STAGE / TOGGLE): Lift target servo to $30^\circ$ hold (`STAGE_ANGLE_DEG`) or drop an already-staged servo flat to $0^\circ$, supporting up to 2 simultaneously staged servos per step.
  - B3 (NEXT STEP / LOCK): Lock staged motors into step buffer, drop flaps flat to $0^\circ$, trigger `LED_STATE_STEP_LOCKED` (2 fast flashes), and increment step buffer index.
  - B4 (SAVE & EXIT): Commit sequence buffer to NVS flash storage (`storage_save_routine()`) with IEEE 802.3 CRC32 calculation, turn LED solid ON for 2.0s (`LED_STATE_SAVE_SUCCESS`), and return to Daily Run Mode.
- Implemented visual programming safeguards & failsafes:
  - 2-Motor Limit: Staging a 3rd motor in 1 step is rejected with `LED_STATE_INPUT_ERROR` (3 fast flashes).
  - Empty Step Skip: Pressing B3 with no staged flaps is rejected without recording an empty step.
  - 16-Step Maximum Cap: Locking the 16th step automatically commits the sequence to NVS flash and returns to Daily Run Mode.
  - 20-Second Inactivity Watchdog: 20,000ms countdown timer without user input automatically drops all flaps to $0^\circ$, discards uncommitted buffer, and safely returns to `STATE_IDLE_RUN`.
- Implemented dynamic button gesture routing in `firmware/main/buttons.c` conditioned on system state (`buttons_translate_gesture`) and integrated 10ms state machine ticks in `app_ui_task` on Core 1.
- Created comprehensive host unit test suite `firmware/test/test_state_machine.c` with 161/161 checks passing (503/503 total project checks passing across all 6 test suites).
- Integrated state machine initialization and command routing in `firmware/main/main.c` and registered in `firmware/main/CMakeLists.txt` and `firmware/Makefile`.
- Updated firmware roadmap marking Phase 6 as complete.
- Implemented Phase 5 Motion Engine & Daily Run Mode Execution (`firmware/main/motion.h`, `firmware/main/motion.c`).
- Built Core 0 real-time high-priority motion task (`app_motion_task`, Priority 10) orchestrating deterministic step execution ($0^\circ \to 180^\circ \to 0^\circ$).
- Implemented single-motor and parallel dual-motor sweep trajectories with 300ms fold dwell (`FOLD_DWELL_TIME_MS`) and 200ms inter-step settling delay (`INTER_STEP_DELAY_MS`).
- Implemented non-blocking LED state binding (`LED_STATE_RUNNING` during routine motion, `LED_STATE_IDLE` on clean homing completion).
- Implemented Daily Run Mode trigger dispatcher (`motion_trigger_preset`) loading routines directly from NVS flash storage for Presets 1–4.
- Implemented safety safeguards: empty preset protection (`routine.step_count == 0` flashes `LED_STATE_INPUT_ERROR` with zero motor actuation), re-entrancy / busy guard, and parameter bounds validation.
- Implemented low-latency Emergency Stop (`motion_emergency_stop`) preemption (<50ms abort latency) immediately cutting PWM commands, homing all 16 channels to $0^\circ$, triggering `LED_STATE_ESTOP` (5 rapid flashes), and ensuring FreeRTOS event group bits cleanly auto-clear on subsequent routine triggers.
- Created host unit test suite `firmware/test/test_motion.c` with 74/74 checks passing (342/342 total project checks passing across all 5 test suites).
- Integrated motion engine lifecycle and command routing in `firmware/main/main.c` and registered in `firmware/main/CMakeLists.txt` and `firmware/Makefile`.
- Updated firmware roadmap marking Phase 5 as complete.
- Implemented Phase 4 Non-Volatile Storage (NVS) Sequence Manager (`firmware/main/storage.h`, `firmware/main/storage.c`).
- Initialized ESP-IDF NVS flash subsystem with auto-recovery and partition format on truncation/version upgrade (`ESP_ERR_NVS_NO_FREE_PAGES` / `ESP_ERR_NVS_NEW_VERSION_FOUND`).
- Implemented binary serialization schema for `fold_routine_t` and `fold_step_t` structs under `"fabrica"` NVS namespace with keys `"preset_1"` to `"preset_4"`.
- Implemented standard IEEE 802.3 CRC32 integrity validation engine (`0xEDB88320` polynomial) covering serialized sequence payloads to guard against flash corruption and incomplete writes.
- Implemented full CRUD sequence operations (`storage_save_routine`, `storage_load_routine`, `storage_erase_routine`) with graceful fallbacks to factory defaults on corruption or uninitialized slots.
- Seeded factory default routines for 4 standard garment profiles: Preset 1 (Adult T-Shirt, 3 steps), Preset 2 (Long-Sleeve Shirt, 3 steps), Preset 3 (Trousers/Jeans, 2 steps), and Preset 4 (Towel/Linen, 3 steps).
- Created host unit test suite `firmware/test/test_storage.c` with 65/65 checks passing (261/261 total project checks passing across all 4 test suites).
- Integrated NVS storage manager initialization and preset boot diagnostics into `firmware/main/main.c`.
- Updated firmware roadmap marking Phase 4 as complete.
- Migrated PCA9685 driver to ESP-IDF v5.2+ `driver/i2c_master.h` bus and device handle architecture, resolving driver deprecation warnings.
- Implemented Phase 3 I2C PCA9685 16-Channel PWM Servo Driver (`firmware/main/pca9685.h`, `firmware/main/pca9685.c`).
- Configured ESP32 I2C Master peripheral on GPIO 21 (SDA) and GPIO 22 (SCL) at 100 kHz.
- Configured PCA9685 controller at address `0x40`: prescale set to 121 (50 Hz PWM / 20ms period), Auto-Increment enabled, and totem-pole output drivers configured.
- Implemented high-precision 12-bit angle-to-PWM conversion ($0^\circ \to 180^\circ \implies 500\,\mu\text{s} \to 2500\,\mu\text{s} \implies 102 \to 512$ counts) with mechanical boundary clamping.
- Added API functions for single-channel positioning, synchronized 16-bit multi-channel mask updates, homing all 16 servos to $0^\circ$, physical $15^\circ$ identification nudges, and $30^\circ$ visual staging holds.
- Integrated PCA9685 driver initialization and servo actuation commands into `firmware/main/main.c`.
- Created host unit test suite `firmware/test/test_pca9685.c` with 82/82 checks passing (193/193 total project checks passing across all test suites).
- Verified live firmware on ESP32 Dev Board over serial with physical button actuation and live servo articulation.
- Updated firmware roadmap marking Phase 3 as complete.
- Implemented Phase 2 UI Subsystem with 4-button debouncer and non-blocking status LED pattern engine (`firmware/main/buttons.c`, `firmware/main/led.c`).
- Configured 4-button input scanning on GPIO 4, 16, 17, and 5 with 50ms low-pass debounce filter, short tap (<500ms), and long press (>=3000ms) gesture recognition.
- Implemented non-blocking status LED state machine on GPIO 2 driving 7 visual pulse patterns (idle heartbeat, solid running, programming blink, step lock flash, save success, input error, and rapid E-stop).
- Pinned dedicated FreeRTOS tasks to Core 1 (`app_ui_task` at Priority 5, `app_led_task` at Priority 3) dispatching standardized commands to `xCommandQueue`.
- Added host unit test suite (`firmware/test/test_ui_subsystem.c`) with 61 checks passing (111/111 total project checks passing).
- Verified live firmware on ESP32 Dev Board over serial with physical button actuation and LED feedback.
- Updated firmware roadmap marking Phase 2 as complete.

## 2026-08-26
- Implemented Phase 1 Project Skeleton, Hardware Configuration & Diagnostics (`firmware/`).
- Created single source of truth hardware configuration header (`firmware/main/config.h`) and unified command protocol (`firmware/main/command.h`).
- Implemented boot diagnostics, chip telemetry, and FreeRTOS command queue allocation in `firmware/main/main.c`.
- Added host unit test suite `firmware/test/test_headers.c` with 50/50 checks passing.
- Verified ESP-IDF build compilation and flashed binary to physical ESP32 Dev Board over UART.

## 2026-08-23
- Completed **Phase 6: Full Garment Folding Grid Assembly** (`cad-designs/assembly.py`):
  - Validated universal 6-module garment folding robot assembly combining 2 Base Modules, 2 Follower Modules, 2 Motorized Modules with direct-drive MG996R servos, servo adapters, servo covers, end pivot pins, and 7 interlocking click-lock dovetail frame joiners.
  - Verified 0.00000 mm³ interference across all components and exported production `assembly.step` and `assembly.stl`.
  - Updated `cad-designs/specs/roadmap.md` and `specs/mission.md` marking CAD designs and full assembly as completed.
  - Updated `firmware/README.md` with firmware specification requirements and hardware architecture details.

## 2026-08-22
- Implemented **Phase 5: Interface Module & Electronics Enclosure**:
  - Added `interface_case.py` ($140.0 \times 120.0 \times 45.0\text{ mm}$ compact ergonomic electronics chassis, total assembled $H = 48.0\text{ mm}$, 41% width reduction) featuring sleek $R=8.0\text{ mm}$ filleted vertical corners removing all sharp boxy edges, housing 3 internal circuit boards in an optimized layout: PDB mounted vertically along the left bay (M3 standoffs @ $24.0 \times 37.0\text{ mm}$ pitch), ESP32 DevKit mounted in the front-right bay (M3 standoffs @ $23.0 \times 46.0\text{ mm}$ pitch + cradle), and PCA9685 16-channel PWM servo driver mounted in the rear-right bay (M2.5 standoffs @ $55.88 \times 19.05\text{ mm}$ pitch), with a clean unobstructed floor, continuous 100% flush top perimeter rim, integrated external male sliding dovetail key located on the left end of the rear wall ($X = 25.0\text{ mm}$, $Y = 120.0\text{ mm}$ behind the PDB where no wire holes exist) matching the exact size, flared shape, and $6.8 \times 8.6\text{ mm}$ internal wire raceway of `frame_joiner.py` to route wire harnesses directly from robot base frames into the case power bay, direct wall retention windows cut through the front and rear perimeter walls eliminating internal boss clutter, 16 discrete motor wire slots ($4.0 \times 16.0\text{ mm}$, $Z \in [8.0, 24.0\text{ mm}]$) on $6.0\text{ mm}$ pitch ($2.0\text{ mm}$ solid pillars) on the right half of the rear wall directly behind the PCA9685 servo pin headers, $\varnothing 11.5\text{ mm}$ DC power barrel jack on the left wall, $12.0 \times 7.5\text{ mm}$ USB programming port on the front wall, and passive convection cooling chimneys under all 3 boards.
  - Added `interface_panel.py` ($140.0 \times 120.0 \times 3.0\text{ mm}$ compact flat horizontal top faceplate at $Z = 45.0\text{ mm}$) with matching sleek $R=8.0\text{ mm}$ filleted vertical corners, 4x inline $\varnothing 16.0\text{ mm}$ button cutouts ($0.8\text{ mm}$ top chamfers, widened to $30.0\text{ mm}$ pitch providing $14.0\text{ mm}$ hole gap and $12.0\text{ mm}$ bezel gap), circular round $\varnothing 6.0\text{ mm}$ status LED window ($0.8\text{ mm}$ chamfer + $\varnothing 8.5\text{ mm}$ underside retention lip), 4-sided toolless screw-free snap-lock retention system with 4x cantilever snap tabs clicking directly into front/rear wall windows and continuous side register down-ribs, and $0.6\text{ mm}$ diamond micro-grip surface texture.
  - Added `interface_assembly.py` multi-body sub-assembly model with CAD references for PDB, PCA9685, ESP32, 4x 16mm push buttons, and 5mm round status LED indicator in compact filleted rectangular configuration.
  - Standardized all interface component naming with the uniform `interface_` prefix (`interface_case.py`, `interface_panel.py`, `interface_assembly.py`).
  - Validated zero geometric interference ($0.00000\,\text{mm}^3$ overlap across all 12 mated pairs) via FreeCAD MCP `check_interference`.
  - Expanded production export pipeline (`export_all.py`) to 16/16 scripts building with a 100% pass rate.
- Updated Phase 5 roadmap in `cad-designs/specs/roadmap.md` and added `BUTTON_HOLE_DIA = 16.0` to `cad-designs/params.py` and `tech-stack.md` for standard Ø16.0mm round interface push buttons.
- Standardized all project specifications (`specs/mission.md`, `cad-designs/specs/mission.md`, `cad-designs/specs/tech-stack.md`, `docs/README.md`, `firmware/README.md`) on dual internal circuit boards: PCA9685 16-channel PWM servo driver + ESP32 DevKit microcontroller with 4 top interaction buttons and status LED.
- Updated Bambu Lab 3MF print project to `cad-designs/3d-print/fabrica-bambu-lab-256.3mf` configured for 256x256mm build volume.

## 2026-08-21
- Implemented 50/50 split on `motorized_frame.py` left wall ($6.20\text{mm}$ total width), extending the outer $3.10\text{mm}$ to full height ($Z=27.2\text{mm}$) and the inner $3.10\text{mm}$ as a support ledge ($Z=25.8\text{mm}$); resized `motorized_servo_cover.py` to $60.8\text{mm}$ width ($X \in [-20.6, 40.2\text{mm}]$) to sit in a dedicated 3-wall captive recessed pocket.
- Reduced `motorized_frame.py` motor wire pass-through conduit to a fitted $10.0\text{mm} \times 8.6\text{mm}$ port with $1.5\text{mm}$ corner fillets centered at $(Y=205.5\text{mm}, Z=15.0\text{mm})$, eliminating the oversized $20\text{mm}$ void and restoring a $5.45\text{mm}$ solid base wall and $7.9\text{mm}$ top rail bridge.
- Standardized `motorized_servo_adapter.py` on a continuous 100% solid core 8.0mm male hex peg (18.0mm length, 7.7mm AF) with 2.55–3.15mm radial clearance to 4x M2/M2.5 horn-mounting screw heads, enabling straight-line screwdriver access and robust torsional shear resistance.
- Implemented 180° flap folding kinematic relief cuts along hinge pedestals on both Follower Frame and Motorized Frame, enabling 100% collision-free 0° to 180° rotation sweep ($0.0000\,\text{mm}^3$ overlap).
- Bounded outer corner trim cutters to strictly $3.0\text{mm} \times 3.0\text{mm}$ boxes across all frames and flaps, eliminating oversized OpenCASCADE boolean bounding box protrusions.
- Corrected `motorized_servo_adapter.py` hex drive peg length to $18.0\text{mm}$, ensuring $8.0\text{mm}$ positive torque engagement into the motorized flap's female hex socket with $2.0\text{mm}$ bottom clearance.
- Verified $1.0\text{mm}$ axial air gap between rotating adapter flange and frame knuckle, guaranteeing zero contact and zero friction under high servo torque.
- Fused continuous bore and pocket cutters and re-punched bore channels after chamfering to eliminate OpenCASCADE co-planar inversion artifacts.
- Validated all 13 production STEP and STL assets with 100% build pass via `export_all.py`.

## 2026-08-20
- Eliminated flat chord facet and texture cutter grooves on folding flap hinge spines, ensuring a 100% smooth, continuous Ø12.8mm circular cylindrical surface.
- Extended Follower and Motorized folding flaps into full-square top decks (219.0mm x 219.5mm) completely covering chassis top and bottom rails.
- Added smooth 0.50mm radial knuckle relief notches (R=9.9mm) preserving full 0° to 180° rotation clearance with zero collision.
- Extended 45° anti-slip diamond micro-grip traction texture and 2.0mm perimeter shadow bevels continuously across full square flap blades.
- Added captive flanged thrust-collar end pivot pin (`end_pivot_pin.py`) with 100% solid construction, Ø16.0mm x 1.0mm retaining disk, and 0.45mm FDM rotating clearance.
- Updated follower and motorized frames with 100% closed 360° cylindrical bearing knuckles (Ø13.7mm bore) and inner Ø16.8mm x 1.2mm counterbore thrust recesses.
- Redesigned follower and motorized flaps into modular drop-in units with full 360° cylindrical axle spines and 100% fully-enclosed 6-sided 8.0mm female hex torque sockets.
- Updated hex drive coupler (`hex_drive_coupler.py`) with 100% solid core and central Ø15.0mm x 2.0mm axial centering collar for anti-wandering lock.
- Refined chassis outer corners and knuckle barrels with cylinder-bounded 1.0mm x 45° circular outer rim chamfers, 0.8mm bore entry chamfers, and smooth planar rail faces.
- Verified 0.00000 mm³ boolean interference across all assemblies and exported all 13 production STEP and STL models.

## 2026-08-18
- Unified monolithic seamless flap construction across all folding flaps, eliminating internal seam split lines and creating unbroken planar top decks.
- Extended stepped wings on follower and motorized flaps to cover chassis rails past 360° knuckle rings with 0.50mm radial clearance.
- Extended anti-slip 45° diamond traction micro-grip texture continuously across entire flap faces with uniform 2.0mm perimeter shadow bevel borders.
- Extended motorized flap to full 219.0mm length deck coverage over the frame cavity with precision servo notch and zero kinematic interference across 180° rotation.
- Re-architected frame hinge support to a single semi-cylindrical cradle wall, maximizing open cavity space without redundant rectangular walls.
- Added reinforced sub-bore cradle foundation boss and symmetric 0.20mm tight-fit sliding dovetail joint across cradle walls to eliminate looseness and wobble.
- Added high-capacity filleted wire pass-through conduits through all chassis dovetail sockets for continuous cable routing into interior wiring cavities.
- Added smooth R=3.0mm vertical corner fillets and lead-in chamfers across all frames, flaps, and drive axles for tactile finish and supportless FDM printing.
- Implemented solid servo bay bed floor at Z=5.25mm for direct gravity-supported drop-in motor seating and M3 screw hole alignment.
- Converted motorized frame cavity to a unified monolithic L-shaped boundary, eliminating split-line rail notches and motor enclosure slivers.
- Flattened motorized chassis bottom to 100% planar Z=0.0mm coplanar base across entire footprint, eliminating bottom protrusion step and table rocking.
- Extended continuous flat solid base plate under knuckle and motor housing zone across X=[-24, +48mm] at Z=0.0mm with smooth outer corner filleting.
- Repositioned motor mounting towers to Y=182.0mm and motor bay to Y=[182.0, 214.5mm] to accommodate the 48.05mm total motor + circular horn length without overlap.
- Redesigned motorized servo adapter with 4.3mm thickness (Y=[159.5, 163.8mm]), seating flush against the MG996R round horn disk and engaging flap top hex socket with zero axial interference.
- Converted motor mounting walls into 5.0mm thick tower posts at Y=[182.0, 187.0mm] and widened drop-in bay cavity to 56.3mm (X=[-17.8, +38.5mm]), eliminating solid side shelves and providing complete top drop-in clearance and direct screwdriver/bolt access to all 4x M3 mounting holes.
- Removed obsolete split-seam dovetail cut and cradle boss from both motorized and follower frames, creating continuous, unbroken, smooth semi-cylindrical cradle troughs for elastic snap-in flap assembly.
- Implemented full-length solid vertical base pedestal along the entire 220mm hinge rail ($X \in [-9.4, 0\text{ mm}], Z \in [0.0, 15.0\text{ mm}]$) on both follower and motorized frames, eliminating circular underside overhangs for 100% supportless FDM printing, planar tabletop seating, and tripled hinge stiffness.
- Rebuilt and validated all 12 production STEP and STL files with 100% build pass.

## 2026-08-17
- Standardized True Square 220.0mm x 220.0mm modular panel architecture across all modules with symmetrical 230.0mm inter-module pitch and 10.0mm seam gaps.
- Decoupled all physical hardware features (MG996R servo motor bay, M3 fastener bosses, snap-fit lids, 8.0mm hex torque couplers, sliding dovetails, silicone foot sockets, and FDM clearances) from build plate scaling parameters, locking them to unscaled 1:1 physical constants.
- Standardized canonical top-level 6-module universal garment folding robot assembly as `cad-designs/assembly.py`, exporting `assembly.step` and `assembly.stl`.
- Updated `cad-designs/export_all.py` to automatically batch build and export all 3 assemblies and 9 individual printable parts (26 STEP & STL production files) in a single pass.
- Completed comprehensive FreeCAD visual, manifold solid, and 3D Boolean interference validation with 0.00000 mm³ overlap across all mating component interfaces.
- Marked Phase 4 (Active Motorized Module) as completed and production certified for 3D printing.

## 2026-08-15
- Re-architected Active Motorized Module (`cad-designs/motorized_frame.py`, `motorized_flap.py`, `motorized_servo_cover.py`, `motorized_assembly.py`) with a **horizontal inline direct-drive servo mount**, eliminating the $+22\text{ mm}$ top motor bump and creating a **100% flush, coplanar top deck ($Z = 15.0\text{..}17.5\text{ mm}$)** across the entire module with $0.00000\text{ mm}^3$ interference across all 9 mating pairs.
- Updated Active Flap (`motorized_flap.py`) to a full rectangular blade with integrated continuous $\varnothing 13.0\text{ mm}$ drive axle, 25T metal horn socket, bottom $8.0\text{ mm}$ hex torque socket, and gradient mass-reduction cutouts.
- Designed flush low-profile slide-in servo lid (`motorized_servo_cover.py`) with side retention tongues and passive cooling gills.
- Updated Base Module chassis (`cad-designs/base_module.py`) to the clean 4-wall open-bottom frame architecture, removing debossed directional reticles/lines and top TPU bumper slots for a completely flat and uniform top deck, while retaining circular mass-reduction cutouts, diamond knurling, sliding dovetails, and anti-slip feet.
- Synchronized all CAD specs in `cad-designs/specs/` (`requirements.md`, `plan.md`, `roadmap.md`, `tech-stack.md`) to match the latest 4-wall open-bottom chassis architecture and standardized `motorized_` / `follower_` naming conventions.
- Standardized CAD naming conventions with `motorized_` and `follower_` prefixes (`motorized_frame.py`, `motorized_flap.py`, `motorized_servo_cover.py`, `motorized_assembly.py`, `follower_frame.py`, `follower_flap.py`, `follower_assembly.py`).
- Implemented Phase 4 Active Motorized Module (`cad-designs/motorized_frame.py`, `cad-designs/active_flap.py`, `cad-designs/servo_cover.py`, `cad-designs/assembly_motorized_module.py`) with 0.00000 mm³ interference across all mating pairs.
- Designed 4-sided active motorized chassis frame (`motorized_frame.py`) with dual Ø13.5mm closed bearing knuckles, integrated MG996R servo mounting bay with M3 screw bosses, cable routing conduit, and snap-latch cover sockets.
- Modeled monolithic active folding flap (`active_flap.py`) with continuous Ø13.0mm solid-core drive axle, integrated 25T metal servo horn socket with M3 central retention screw counterbore, bottom 8.0mm female hex torque socket, and corner servo clearance notch.
- Modeled toolless snap-latch protective servo cover (`servo_cover.py`) featuring dual cantilever snap tabs with 0.4mm detents, wire exit notch, and top convection cooling ventilation gills.
- Created complete motorized module sub-assembly script (`assembly_motorized_module.py`) with MG996R servo CAD reference, frame joiners, and hex coupler pin.
- Verified visual bursts, exploded inspection, XZ section cuts, and boolean interference (`0.00000 mm³` overlap) via FreeCAD MCP tools.
- Updated `export_all.py` batch build pipeline to automatically build and export all 10 CAD parts and assemblies to `cad-designs/exports/`.

## 2026-08-14
- Implemented Phase 3 Passive Follower Module (`part_02_follower_frame.py`, `part_03_follower_flap.py`, `part_11_hex_drive_coupler.py`, `assembly_follower_module.py`) with 0.000 mm³ interference across all components.
- Designed 4-sided open-bottom follower frame with integrated male-female interlocking dovetail joint on the 4th stiffener tie-bar (flush at Z=3.0mm with 0.25mm clearance and zero floating slivers).
- Added 4x bottom anti-slip grip foot sockets (Ø12.0mm x 2.0mm) and top-rail silent-flip TPU bumper landing slots.
- Implemented dual 100% solid 360° closed cylindrical bearing knuckles with C1-continuous concave blend transition ramps.
- Designed full-size 240x240mm rotating follower flap resting on frame rails with continuous full-length Ø13.0mm drive axle, dual 8.0mm female hex torque sockets, and gradient circular weight-reduction cutouts (~45% mass reduction).
- Modeled compact 31.0mm solid double-male hex drive coupler bridging 10.0mm inter-module gaps with cylindrical bearing journal.
- Updated true open-top sliding dovetail sockets with Ø6.0mm through-floor push-out access holes across base and follower chassis.
- Optimized `part_10_frame_joiner.py` for fast headless execution, eliminating boolean meshing bottlenecks during STEP and STL export.
- Redesigned Click-Lock Dovetail Frame Joiner to be 100% 3-axis symmetrical ($X, Y, Z$) for zero-orientation Poka-Yoke assembly.
- Enlarged internal wire raceway in `part_10_frame_joiner.py` to $5.8\text{ mm} \times 7.2\text{ mm}$ with filleted corners to accommodate pre-crimped 3-pin servo connectors and multi-wire harnesses.
- Added 4-corner $45^\circ$ lead-in entry chamfers, $1.2\text{ mm}$ central indexing/pry lip collar, and tactile retention detents for effortless tool-free attachment and removal.

## 2026-08-08
- Created initial project scaffolding for `cad-designs`, `firmware`, `docs`, and `mobile-app` subdirectories.
- Added `specs/mission.md` detailing the project vision, high-level system architecture, four core deliverables, and roadmap.
- Added system reference images and CAD visuals under `specs/reference-images`.
- Refined CAD design specifications for Fabrica Cloth Folding Robot across `mission.md`, `tech-stack.md`, and `roadmap.md`.
- Implemented Phase 1 parametric foundation script (`params.py`), headless build script (`export_all.py`), executable shell entrypoint (`run.sh`), and standard directory layout.
- Optimized modular 4×3 grid architecture, consolidating the central column into a Monolithic Base Chassis Module and selecting Click-Lock Hollow Dovetail Frame Joiners for toolless assembly and hidden cable routing.
- Harmonized universal CAD design standards (Poka-Yoke directional arrows, Elephant's Foot bed relief, micro-grip diamond texture, hole chamfers, filleted wire ports, and click-lock dovetail sockets) across all 10 module part files.
- Added 1.2 mm recessed perimeter shadow bevel (`ACCENT_BEVEL_DEPTH`) for dual-tone panel aesthetics on the Follower Folding Flap.
- Implemented Phase 2 CAD parts (`part_01_base_module.py` and `part_10_frame_joiner.py`) with 3.0mm hex lattice, anti-slip foot sockets, garment reticles, TPU bumper slots, filleted wire ports, click-lock dovetail sockets, and 0.000 mm³ interference validation pass.
- Restructured `cad-designs` folder layout, moving all 10 individual part scripts directly under `cad-designs/` for flatter project architecture.
