aiandrobotics/fabrica/firmware/main/main.c

#include <stdio.h>
#include <inttypes.h>
#include "freertos/FreeRTOS.h"
#include "freertos/task.h"
#include "freertos/queue.h"
#include "freertos/event_groups.h"
#include "esp_system.h"
#include "esp_chip_info.h"
#include "esp_flash.h"
#include "esp_log.h"

#include "config.h"
#include "command.h"
#include "led.h"
#include "buttons.h"
#include "pca9685.h"
#include "storage.h"
#include "motion.h"
#include "state_machine.h"
#include "ble_transport.h"
#include "telemetry.h"

static const char *TAG = "FABRICA_MAIN";

/* Application-Scoped Inter-Task Communication Handles */
static QueueHandle_t s_command_queue = NULL;
static EventGroupHandle_t s_system_event_group = NULL;

/**
 * @brief Print comprehensive chip diagnostics and system telemetry to UART console.
 *
 * Logs chip revision, core count, clock frequency, flash size, free heap, and tick rate.
 */
static void print_system_diagnostics(void)
{
    esp_chip_info_t chip_info;
    esp_chip_info(&chip_info);

    uint32_t flash_size_bytes = 0;
    esp_flash_get_size(NULL, &flash_size_bytes);
    uint32_t flash_size_mb = flash_size_bytes / (1024 * 1024);

    size_t free_heap = esp_get_free_heap_size();
    size_t min_free_heap = esp_get_minimum_free_heap_size();

    ESP_LOGI(TAG, "============================================================");
    ESP_LOGI(TAG, " Fabrica Cloth Folding Robot - ESP32 Firmware");
    ESP_LOGI(TAG, " System State Machine & Preset Engine Ready");
    ESP_LOGI(TAG, "============================================================");

    ESP_LOGI(TAG, "Chip Model       : %s", (chip_info.model == CHIP_ESP32) ? "ESP32" : "Unknown");
    ESP_LOGI(TAG, "Silicon Revision : %d", chip_info.revision);
    ESP_LOGI(TAG, "CPU Cores        : %d @ 240 MHz", chip_info.cores);
    ESP_LOGI(TAG, "Features         : %s%s%s",
             (chip_info.features & CHIP_FEATURE_WIFI_BGN) ? "802.11b/g/n " : "",
             (chip_info.features & CHIP_FEATURE_BT) ? "BT " : "",
             (chip_info.features & CHIP_FEATURE_BLE) ? "BLE" : "");
    ESP_LOGI(TAG, "SPI Flash Size   : %" PRIu32 " MB (%s)", flash_size_mb,
             (chip_info.features & CHIP_FEATURE_EMB_FLASH) ? "Embedded" : "External");
    ESP_LOGI(TAG, "Current Free Heap: %u bytes (%u KB)", (unsigned int)free_heap, (unsigned int)(free_heap / 1024));
    ESP_LOGI(TAG, "Minimum Free Heap: %u bytes (%u KB)", (unsigned int)min_free_heap, (unsigned int)(min_free_heap / 1024));
    ESP_LOGI(TAG, "Tick Rate        : %d Hz (1 ms tick)", CONFIG_FREERTOS_HZ);
    ESP_LOGI(TAG, "------------------------------------------------------------");
}

/**
 * @brief Allocate and initialize FreeRTOS inter-task communication queues and event groups.
 *
 * Creates:
 *   - xCommandQueue: Thread-safe FIFO for button gestures and motion commands.
 *   - xSystemEventGroup: Bitflags for motion synchronization and emergency stops.
 *
 * @return ESP_OK on success, ESP_ERR_NO_MEM on heap allocation failure.
 */
static esp_err_t init_ipc_primitives(void)
{
    ESP_LOGI(TAG, "Initializing FreeRTOS IPC primitives...");

    /* Allocate unified command queue */
    s_command_queue = xQueueCreate(COMMAND_QUEUE_LENGTH, sizeof(command_t));
    if (s_command_queue == NULL) {
        ESP_LOGE(TAG, "Failed to create s_command_queue! Insufficient heap memory.");
        return ESP_ERR_NO_MEM;
    }
    ESP_LOGI(TAG, "Command Queue created (Depth: %d, Item Size: %zu bytes)",
             COMMAND_QUEUE_LENGTH, sizeof(command_t));

    /* Allocate system event group for state synchronization and E-Stop */
    s_system_event_group = xEventGroupCreate();
    if (s_system_event_group == NULL) {
        ESP_LOGE(TAG, "Failed to create s_system_event_group! Insufficient heap memory.");
        return ESP_ERR_NO_MEM;
    }
    ESP_LOGI(TAG, "System Event Group created successfully.");

    return ESP_OK;
}

/**
 * @brief Application entrypoint executing on Core 0.
 *
 * Orchestrates subsystem initialization (LED, Buttons, PCA9685, NVS Storage,
 * Motion Engine, State Machine), then enters the main command consumer event loop.
 */
void app_main(void)
{
    /* 1. Print Startup Banner & Telemetry */
    print_system_diagnostics();

    /* 2. Initialize FreeRTOS Queues & Events */
    esp_err_t err = init_ipc_primitives();
    if (err != ESP_OK) {
        ESP_LOGE(TAG, "System bootstrap failed with error: %s (0x%x)", esp_err_to_name(err), err);
        return;
    }

    ESP_LOGI(TAG, "GPIO Configuration: LED=%d, B1=%d, B2=%d, B3=%d, B4=%d, SDA=%d, SCL=%d",
             STATUS_LED_GPIO, BTN1_GPIO, BTN2_GPIO, BTN3_GPIO, BTN4_GPIO, I2C_SDA_GPIO, I2C_SCL_GPIO);
    ESP_LOGI(TAG, "PCA9685 Driver: Addr=0x%02X, PWM Freq=%d Hz, Channels=%d",
             PCA9685_I2C_ADDR, PCA9685_PWM_FREQ_HZ, TOTAL_SERVO_CHANNELS);

    /* 3. Initialize Status LED Engine (Core 1) */
    err = led_init();
    if (err != ESP_OK) {
        ESP_LOGE(TAG, "Failed to initialize Status LED engine: %s", esp_err_to_name(err));
        return;
    }

    /* 4. Initialize 4-Button Subsystem (Core 1) */
    buttons_set_command_queue(s_command_queue);
    err = buttons_init();
    if (err != ESP_OK) {
        ESP_LOGE(TAG, "Failed to initialize 4-Button subsystem: %s", esp_err_to_name(err));
        return;
    }

    /* 5. Initialize PCA9685 16-Channel PWM Servo Driver (I2C Master on Core 0) */
    err = pca9685_init();
    if (err != ESP_OK) {
        ESP_LOGW(TAG, "PCA9685 initialization returned: %s (Check I2C bus wiring/pullups)", esp_err_to_name(err));
    } else {
        ESP_LOGI(TAG, "PCA9685 driver ready. All 16 channels initialized to home position (0 deg).");
    }

    /* 6. Initialize Non-Volatile Storage (NVS) Sequence Manager */
    err = storage_init();
    if (err != ESP_OK) {
        ESP_LOGE(TAG, "Failed to initialize NVS storage manager: %s", esp_err_to_name(err));
    } else {
        ESP_LOGI(TAG, "NVS Storage Manager initialized successfully. Loading presets...");
        for (uint8_t id = 1; id <= TOTAL_PRESET_COUNT; id++) {
            fold_routine_t routine;
            if (storage_load_routine(id, &routine) == ESP_OK) {
                ESP_LOGI(TAG, "  [Preset %d] Loaded: %d steps, Checksum: 0x%08" PRIX32,
                         id, routine.step_count, routine.checksum);
            }
        }
    }

    /* 7. Initialize Core 0 Real-Time Motion Engine */
    err = motion_init(s_system_event_group);
    if (err != ESP_OK) {
        ESP_LOGE(TAG, "Failed to initialize Motion Engine: %s", esp_err_to_name(err));
    } else {
        ESP_LOGI(TAG, "Real-Time Motion Engine initialized on Core 0.");
    }

    /* 8. Initialize System State Machine Coordinator */
    state_machine_set_command_queue(s_command_queue);
    err = state_machine_init();
    if (err != ESP_OK) {
        ESP_LOGE(TAG, "Failed to initialize State Machine: %s", esp_err_to_name(err));
    } else {
        ESP_LOGI(TAG, "System State Machine initialized.");
    }

    /* 9. Initialize Apache NimBLE GATT Server on Core 1 */
    err = ble_transport_start(s_command_queue);
    if (err != ESP_OK) {
        ESP_LOGE(TAG, "Failed to initialize BLE Transport on Core 1: %s", esp_err_to_name(err));
    } else {
        ESP_LOGI(TAG, "BLE GATT Server ready (%s). Free Heap: %u bytes (%u KB)",
                 ble_transport_get_device_name(),
                 (unsigned int)esp_get_free_heap_size(),
                 (unsigned int)(esp_get_free_heap_size() / 1024U));
    }

    /* 10. Initialize Adaptive Telemetry Subsystem on Core 1 */
    err = telemetry_init();
    if (err != ESP_OK) {
        ESP_LOGE(TAG, "Failed to initialize Telemetry subsystem: %s", esp_err_to_name(err));
    } else {
        ESP_LOGI(TAG, "Adaptive Telemetry Subsystem ready on Core 1 (10 Hz in motion, 1 Hz idle).");
    }

    /* 11. Auto-start 120s BLE pairing window on fresh boot if zero devices are bonded */
    state_machine_check_initial_pairing();

    ESP_LOGI(TAG, "System initialization complete. Awaiting button, BLE & motion commands...");

    /* 12. Command Queue Consumer Loop */
    command_t cmd;
    while (1) {
        if (xQueueReceive(s_command_queue, &cmd, portMAX_DELAY) == pdTRUE) {
            ESP_LOGI(TAG, "[CMD RECEIVED] Type: %d, Source: %d, Preset/Payload: %d",
                     cmd.type, cmd.source, cmd.payload.preset_id);

            esp_err_t proc_err = state_machine_process_command(&cmd);
            if (proc_err != ESP_OK) {
                ESP_LOGW(TAG, "Command processing returned: %s (0x%x)", esp_err_to_name(proc_err), proc_err);
            }
        }
    }
}
