aiandrobotics/fabrica/firmware/main/buttons.h

#pragma once
#ifndef FABRICA_BUTTONS_H
#define FABRICA_BUTTONS_H

#include <stdint.h>
#include <stdbool.h>
#ifdef ESP_PLATFORM
#include "esp_err.h"
#else
typedef int esp_err_t;
#ifndef ESP_OK
#define ESP_OK          0
#endif
#ifndef ESP_FAIL
#define ESP_FAIL        -1
#endif
#ifndef ESP_ERR_NO_MEM
#define ESP_ERR_NO_MEM  0x101
#endif
#endif
#include "config.h"
#include "command.h"
#include "state_machine.h"

#ifdef ESP_PLATFORM
#include "freertos/FreeRTOS.h"
#include "freertos/queue.h"
#endif

#ifdef __cplusplus
extern "C" {
#endif

/**
 * @brief Zero-indexed button identifiers.
 */
typedef enum {
    BTN_ID_1 = 0, /* Button 1: Preset 1 (Adult T-Shirt) */
    BTN_ID_2 = 1, /* Button 2: Preset 2 (Long-Sleeve Shirt) */
    BTN_ID_3 = 2, /* Button 3: Preset 3 (Trousers / Jeans) */
    BTN_ID_4 = 3, /* Button 4: Preset 4 (Towel / Linen) */
    BTN_ID_COUNT = 4
} button_id_t;

/**
 * @brief Detected physical button gesture types.
 */
typedef enum {
    GESTURE_NONE = 0,
    GESTURE_SHORT_TAP = 1,   /**< Pressed and released in < 500ms */
    GESTURE_LONG_PRESS = 2,  /**< Single button held continuously for >= 3000ms */
    GESTURE_BOND_RESET = 3,  /**< B1 + B4 held simultaneously for >= 5000ms */
    GESTURE_FACTORY_RESET = 4 /**< B1 + B3 + B4 held simultaneously for >= 10000ms */
} button_gesture_t;

/**
 * @brief Per-button debouncing and gesture tracking state.
 */
typedef struct {
    uint8_t gpio_num;
    int current_stable_state;    /**< Stable logical state: 0 = Pressed, 1 = Released */
    int last_raw_level;          /**< Most recent raw GPIO reading */
    uint32_t debounce_timer_ms;  /**< Time raw level has differed from stable state */
    uint32_t press_duration_ms;  /**< Accumulated continuous press duration */
    bool long_press_triggered;   /**< Flag to ensure single long press event dispatch */
} button_state_t;

/**
 * @brief Initialize 4-button GPIOs with pull-ups and spawn app_ui_task on Core 1.
 * @return ESP_OK on success, or ESP error code.
 */
esp_err_t buttons_init(void);

/**
 * @brief Process one sampling tick across all 4 buttons.
 * @param elapsed_ms Elapsed milliseconds since previous tick (typically 10ms).
 */
void buttons_process_tick(uint32_t elapsed_ms);

/**
 * @brief Process single button step with simulated raw level (for unit tests).
 * @param btn_idx Button index (0 to 3).
 * @param raw_level Raw GPIO level (0 = Pressed, 1 = Released).
 * @param elapsed_ms Elapsed time in ms.
 * @return Detected gesture, if any on this tick.
 */
button_gesture_t buttons_update_channel(uint8_t btn_idx, int raw_level, uint32_t elapsed_ms);

/**
 * @brief Translate a physical button index and detected gesture into a system command_t
 *        based on current system operating state.
 * @param btn_idx Button index (0 to 3).
 * @param gesture Detected gesture (GESTURE_SHORT_TAP or GESTURE_LONG_PRESS).
 * @param current_state Current operating state (STATE_IDLE_RUN, STATE_RUNNING_MOTION).
 * @return Standardized command_t structure.
 */
command_t buttons_translate_gesture(uint8_t btn_idx, button_gesture_t gesture, system_state_t current_state);

/**
 * @brief Reset internal debouncing and gesture tracking state across all channels.
 */
void buttons_reset_all(void);

/**
 * @brief Query current stable state of a button.
 * @param btn_idx Button index (0 to 3).
 * @return 0 for Pressed, 1 for Released.
 */
int buttons_get_stable_state(uint8_t btn_idx);

#ifdef ESP_PLATFORM
/**
 * @brief Set the command queue destination for button event dispatch.
 * @param queue FreeRTOS command queue handle.
 */
void buttons_set_command_queue(QueueHandle_t queue);
#endif

#ifdef __cplusplus
}
#endif

#endif /* FABRICA_BUTTONS_H */
