aiandrobotics/fabrica/(commit log)

2026-08-08 feat(cad): finalize Phase 0 specs and Phase 1 parametric foundations
2026-08-08 docs(cad): harmonize universal CAD design standards across all module specifications
2026-08-08 feat(cad): add dual-tone perimeter shadow bevel for Follower Folding Flap
2026-08-08 docs(spec): relocate Phase 2 feature spec under cad-designs/specs/ directory
2026-08-08 feat(cad): complete Phase 2 Modular Base Module and Interlocking Joiners
2026-08-08 refactor(cad): flatten cad-designs directory structure, keeping all Python scripts directly under cad-designs/
2026-08-08 feat(cad): upgrade hex lattice in part_01_base_module.py to 100% wall-to-wall coverage
2026-08-08 style(cad): simplify top surface of part_01_base_module.py by removing reticles and arrow deboss
2026-08-08 style(cad): remove top TPU bumper slots from part_01_base_module.py for 100% flat top surface
2026-08-08 feat(cad): add Option B gradient circular chamfered hole pattern to part_01_base_module.py
2026-08-08 style(cad): restore 100% solid flat top bed plate on part_01_base_module.py for folded garment stack support
2026-08-08 fix(cad): unify side wall dovetail sockets on part_01_base_module.py for 100% 4-way symmetry
2026-08-08 fix(cad): correct 4-wall dovetail cutter placement vectors in part_01_base_module.py
2026-08-08 feat(cad): add 100% aligned generative hex top cutouts to part_01_base_module.py
2026-08-08 style(cad): upgrade top hex pattern in part_01_base_module.py to a symmetrical 6-fold radial rosette motif
2026-08-08 feat(cad): upgrade top hex pattern to dense organic hex cluster mesh matching user design preference
2026-08-08 feat(cad): apply 100% symmetrical Central Honeycomb Shield motif to part_01_base_module.py
2026-08-08 feat(cad): lock in user's chosen organic hex cluster pattern for part_01_base_module.py
2026-08-08 feat(cad): apply user's organic hex pattern to part_01_base_module.py and complete phase 3 follower module
2026-08-08 feat(cad): add part_02_follower_frame.py, part_03_follower_flap.py, and assembly_follower_module.py
2026-08-08 fix(cad): fix export_all.py module execution to generate all 5 STEP and STL models
2026-08-09 fix(cad): synchronize dovetail socket and joiner dimensions (16mm -> 10mm x 8mm) across all parts
2026-08-14 feat(cad): optimize part_10_frame_joiner with 3-axis symmetry and high-capacity wire raceway
    [fabrica-bambu-lab.3mf]
2026-08-14 feat(cad): implement 20mm flush bridge joiner and MODULE_GAP parameter
2026-08-14 refactor(cad): remove detent bumps on joiner for smooth friction wedge fit
2026-08-14 feat(cad): expand joiner raceway to 6.8x8.6mm for 3-servo wiring harness capacity
2026-08-14 feat(cad): make 20mm bridge joiner 100% flush across top deck
    [fabrica-bambu-lab.3mf]
2026-08-14 feat(cad): implement Phase 3 passive follower frame, flap, and sub-assembly
2026-08-14 refactor(cad): correct Phase 3 requirements, plan, and CAD models to 3-sided U-frame with full-size flap
2026-08-14 feat(cad): implement True Sliding Dovetail system with outward flare and 12mm deep insertion for rock-solid lock
2026-08-14 feat(cad): make female dovetail sockets open-top with solid 3.0mm floor stop and finger push-out hole
2026-08-14 fix(cad): calibrate joiner height to exactly 12.0mm for 100% flush coplanar deck
    [params.py]
2026-08-14 feat(cad): upgrade follower flap with Ø14mm continuous drive axle and 8mm hex torque couplers
    [fabrica-bambu-lab.3mf]
2026-08-14 feat(cad): align follower flap panel and axle to sit 100% flush at Z=15.0mm tabletop plane
2026-08-14 fix(cad): resolve assembly flap alignment and axle floor clearance (0.000 mm3 interference)
    [fabrica-bambu-lab.3mf]
2026-08-14 feat(cad): add bottom structural reinforcing fillet gusset for maximum torsional hinge strength
2026-08-14 fix(cad): eliminate shadow bevel at hinge root to ensure 100% continuous flat deck to axle
2026-08-14 perf(cad): optimize follower flap blade thickness to 2.4mm for 40% weight reduction & fast flips
2026-08-14 feat(cad): implement full-deck 3-rail overlapping flap with recessed frame landing ledges (0.000 mm3 interference)
2026-08-14 feat(cad): add modular Part 11 double-male hex drive coupler pin & dual symmetrical female flap sockets (0.000 mm3 interference)
2026-08-14 feat(cad): make drive axle core 100% solid along central span for maximum torsional strength
2026-08-14 feat(cad): make follower frame bottom 100% planar flat at Z=0.0mm for zero-support 3D printing & tabletop stability
2026-08-14 feat(cad): implement 360-degree fully enclosed solid knuckle tunnels on both ends (0.000 mm3 interference)
2026-08-14 feat(cad): implement axial slide-in blade slot on bottom knuckle with 360-degree top tunnel (0.000 mm3 interference)
2026-08-14 feat(cad): make axial blade slide slot on bottom knuckle vertically open at top (0.000 mm3 interference)
2026-08-14 feat(cad): implement inner-side gusset pass-through gate on bottom knuckle for 0-deg horizontal slide-in (0.000 mm3 interference)
2026-08-14 feat(cad): implement 1.5mm ground clearance with 6 o'clock bottom slide gate and 100% flush tabletop (0.000 mm3 interference)
    [params.py]
2026-08-14 feat(cad): fill inner rail notch gap and restrict 6 o'clock opening strictly to knuckle barrel (0.000 mm3 interference)
2026-08-15 feat(cad): narrow bottom opening to 3.2mm precision blade slit leaving 5.15mm solid cradle shelves to prevent axle drop (0.000 mm3 interference)
2026-08-15 docs(specs): document 3.2mm precision bottom slit and 5.15mm solid cradle shelves in requirements.md
2026-08-15 feat(cad): implement Option B drop-in flap with dual 360-deg closed knuckle tunnels and modular hex coupler pins (0.000 mm3 interference)
2026-08-15 feat(cad): add 2.75mm reinforced knuckle top crowns with smooth organic tangent transition ramps (0.000 mm3 interference)
2026-08-15 feat(cad): add C1-continuous concave knuckle transition fillet and protect dovetail socket walls from chipped corners (0.000 mm3 interference)
2026-08-15 fix(cad): eliminate dovetail socket wall break by keeping full-height continuous perimeter walls (0.000 mm3 interference)
2026-08-15 fix(cad): remove colliding wire port cutout from dovetail socket wall (100% solid socket walls, 0.000 mm3 interference)
2026-08-15 fix(cad): remove debossed directional arrow that clipped the front dovetail socket entrance (100% clean planar walls)
2026-08-15 feat(cad): enlarge follower flap to 240x240mm landing directly on top of frame rails (0.000 mm3 interference)
2026-08-15 feat(cad): make Part 11 Hex Drive Coupler 100% solid for maximum torsional stiffness
2026-08-15 feat(cad): implement Dual-Ring 20mm Bridge Coupler matching Part 10 module gap (0.000 mm3 interference)
2026-08-15 feat(cad): remove raised collar rings from Part 11 for sleek continuous cylinder bridge (0.000 mm3 interference)
2026-08-15 feat(cad): extend circular journal bearing through 360 rim so hex key begins only inside flap socket (0.000 mm3 interference)
2026-08-15 feat(cad): set MODULE_GAP to 10mm and scale Part 10 and Part 11 connectors accordingly (0.000 mm3 interference)
    [params.py]
2026-08-15 fix(cad): ensure push-out holes punch completely through bottom floor on base and follower frames
2026-08-15 feat(cad): convert follower chassis to open-bottom U-frame with 4x anti-slip foot sockets (0.000 mm3 interference)
2026-08-15 feat(cad): implement 4th stiffener tie-bar, full-length continuous flap axle, and compact 31mm Part 11 coupler (0.000 mm3 interference)
2026-08-15 feat(cad): split 4th tie-bar into two mating halves with center dovetail joiner socket (0.000 mm3 interference)
2026-08-15 feat(cad): implement integrated male-female interlocking dovetail joint on 4th wall (0.000 mm3 interference, flush Z=3mm)
2026-08-15 feat(cad): cut continuous interlocking dovetail joint on 4th wall for clear visibility (0.000 mm3 interference)
2026-08-15 fix(cad): fix 4th wall dovetail joint geometry eliminating thin floating slivers (0.000 mm3 interference)
2026-08-15 fix(cad): perfectly align dovetail corners eliminating dogleg notches (0.000 mm3 interference)
2026-08-15 feat(cad): implement robust large-size snap-lock dovetail with flex slots on 4th wall (0.000 mm3 interference)
2026-08-15 feat(cad): upgrade 4th wall to stepped Z-captive interlocking dovetail preventing vertical lift and eliminating all floating geometry
2026-08-15 feat(cad): convert 4th wall joint to clean solid continuous through-dovetail with zero slits, zero overhangs, zero supports
2026-08-15 feat(cad): refine dovetail proportions with 3mm solid continuous outer walls (0.000 mm3 interference)
2026-08-15 docs(specs): synchronize all spec files with latest Phase 3 design changes (solid dovetail, 13mm axle, hex coupler)
2026-08-15 docs(roadmap): standardize Phase 4 Motorized Module to match 4-sided chassis, through-dovetail, and 13mm axle architecture
2026-08-15 refactor(cad): renumber all parts to continuous 01-10 sequence across code and specs
2026-08-15 refactor(cad): migrate from numbered prefixes to clean descriptive filenames across all parts, assemblies, and specs
2026-08-15 refactor(cad): align all part scripts and assembly with exact freecad-project skill conventions (construct_*, export in construct, main)
2026-08-15 refactor(cad): rename specs to spec and assembly_follower_module.py to assembly.py per /freecad-project skill
2026-08-15 docs(specs): fully synchronize Phase 3 plan, requirements, and validation with assembly.py
2026-08-15 docs(specs): add Phase 4 active motorized module spec
2026-08-15 chore(specs): remove cad spec from root specs, keeping inside cad-designs/specs
2026-08-15 feat(cad): implement Phase 4 Active Motorized Module with visual verification and zero-interference validation
2026-08-15 refactor(cad): standardize file naming with motorized_ and follower_ prefixes for clean module grouping
2026-08-15 refactor(cad): update base_module to 4-wall open-bottom frame architecture
2026-08-15 refactor(cad): remove directional lines on base_module and synchronize cad specs
2026-08-15 refactor(cad): remove TPU bumper slots on base_module and update specs
2026-08-15 feat(cad): implement horizontal direct-drive servo mount with 100% flush top surface and zero interference
2026-08-15 fix(cad): call export_part with placement transform in motorized and follower assemblies
2026-08-15 feat(cad): integrate real mg996r.step model into motorized assembly with zero interference
    [mg996r.step]
2026-08-15 feat(cad): reference specs/reference-images/mg996r.step in motorized assembly
2026-08-15 fix(cad): resolve unclosed dovetail wire in motorized_frame.py to generate valid STEP and STL solids
2026-08-15 fix(cad): resolve motorized frame solid geometry with open 4-wall perimeter and zero interference
2026-08-15 feat(cad): add solid mounting towers with hex nut housings, rear slide-in motor slot, and full enclosure hood cover
2026-08-15 feat(cad): unify PIVOT_Z = 10.0mm across all frames, flaps, and couplers with 100% flat bottom base
2026-08-15 feat(cad): add inner enclosure wall sealing motor bay and 4x M3 mounting screw holes accurately spaced per MG996R specs
2026-08-15 docs(specs): update Phase 4 specs with ServoDriveAdapter and symmetrical dual-hex flap architecture
2026-08-15 feat(cad): implement servo_drive_adapter.py and symmetrical dual-hex motorized flap with zero assembly interference
2026-08-15 fix(build): ensure headless export_part execution across all scripts and generate motorized_assembly STEP/STL
2026-08-15 refactor(cad): rename servo_drive_adapter.py to motorized_servo_adapter.py for consistent module grouping
2026-08-15 style(cad): unify motorized_flap top surface design with follower_flap diamond knurling, organic hole layout, and shadow bevel
2026-08-15 fix(cad): add full solid transverse bridge wall and fully enclose top hex screw towers
2026-08-15 fix(cad): unify motorized_flap female hex torque socket geometry with follower_flap
2026-08-15 fix(cad): align motorized_frame module connectors and TPU bumper layout with follower_frame
2026-08-15 fix(cad): make motorized_servo_adapter hex drive peg 100% solid
2026-08-15 feat(cad): add 2.0mm central hub clearance pocket on rear contact face of motorized_servo_adapter
2026-08-15 feat(cad): update motorized_servo_adapter flange thickness to 6.0mm and adjust mating axle clearances
2026-08-15 feat(cad): add smooth under-flap axle gusset transition profile to motorized_flap matching follower_flap
2026-08-15 feat(cad): implement top drop-in servo bay with solid closed back wall and flush drop-in lid
2026-08-15 feat(cad): add solid 2.0mm bottom base floor to motor container in motorized_frame
2026-08-15 feat(cad): open screw insertion access in front of motor towers and convert to circular holes
2026-08-15 feat(cad): extend solid 2.0mm base floor across Y=170-240mm and anchor knuckle cylinder to base
2026-08-15 feat(cad): implement curved 4th wall with central dovetail split on follower and motorized frames
2026-08-16 fix(cad): correct 4th wall geometry with straight rail, central dovetail split, and smooth curved knuckle fillets
2026-08-16 feat(cad): implement axial cradle support wall with central dovetail split on follower and motorized frames
2026-08-16 feat(cad): remove extra flat ledge and apply smooth curvy borders to axial cradle support wall
2026-08-16 feat(cad): eliminate thin ridge and blend axial cradle seamlessly into base floor with smooth continuous curve
2026-08-16 feat(cad): replace sloping cradle ramp with crisp vertical straight wall from cradle end to base
2026-08-16 feat(cad): add smooth tangential curve merging flap surface into drive axle
2026-08-16 feat(cad): increase dovetail clearances for smooth 3D printing sliding fit
    [params.py]
2026-08-16 feat(cad): expand radial and axial clearances between frame 360 knuckles and flap axle
    [params.py]
2026-08-16 feat(cad): create continuous solid 360 knuckle barrel anchored to base floor on motorized frame
2026-08-16 feat(cad): move motor wire exit port to outer left wall and enclose inner chassis wall
2026-08-16 feat(cad): align wire exit port with MG996R cable grommet spec at Y=196-212mm
2026-08-16 feat(cad): place wire exit window at Y=216-228mm, Z=3-16mm matching MG996R spec drawing
2026-08-16 feat(cad): implement 100% 3D-printable snap-fit motor cover with rear tongue and side snap legs
2026-08-16 feat(cad): add solid horizontal retention bar over rear tongue receiver slot
2026-08-16 feat(cad): expand motor enclosure left wall to 6.2mm thickness (X=-24.0mm)
2026-08-16 feat(cad): reinforce cover tongue with 5mm under-plate overlap & 3mm snap barbs
2026-08-17 feat(cad): add full-scale 6-module universal garment folding robot assembly
2026-08-17 feat(cad): optimize all components to fit within 245mm build envelope
2026-08-17 feat(cad): compile final universal cloth folding robot STEP and STL assembly
2026-08-17 feat(cad): establish unscaled physical MG996R hardware constants across parametric panel profiles
2026-08-17 feat(cad): establish True Square 220mm modular panel standard and rebuild all STEP/STL models
2026-08-17 refactor(cad): lock all mechanical interfaces, FDM tolerances, and hardware features to unscaled physical constants
2026-08-17 refactor(cad): rename universal_folding_robot_assembly.py to assembly.py as canonical top-level assembly
2026-08-17 fix(cad): fix doc initialization in follower_assembly.py and export all 3 assemblies
2026-08-17 docs(specs): add MG996R CAD reference models and clean assembly.py
    [mg996r.step]
2026-08-17 fix(cad): remove duplicate universal_folding_robot_assembly alias export
    [assembly.py]
2026-08-17 refactor(cad): remove all unused variables and imports across codebase
2026-08-17 fix(cad): fix undefined PADDLE_THICKNESS in follower_flap.py and harden export_all error detection
    [export_all.py]
2026-08-18 feat(cad): monolithic full-coverage flap panels, cradle support chassis, and tight dovetail joints
    [params.py]
2026-08-18 feat(cad): add wire pass-through conduits in dovetail sockets and edge filleting across parts
2026-08-18 fix(cad): remove split cavity artifacts, right rail notch, and thin motor enclosure sliver on motorized frame
2026-08-18 fix(cad): raise servo bay bed floor to Z=5.25mm for direct motor resting support and screw alignment
2026-08-18 fix(cad): flatten motorized chassis bottom to 100% planar Z=0.0mm eliminating bottom step and rocking
2026-08-18 fix(cad): extend continuous flat solid base plate under knuckle and motor housing zone
2026-08-18 feat(cad): use MG996R.step from cad-designs/3d-print/ in motorized and universal folding robot assemblies
    [MG996R.step, mg996r.step]
2026-08-18 refactor(cad): delete specs/reference-images/mg996r.step and exclusively use cad-designs/3d-print/MG996R.step
    [mg996r.step]
2026-08-18 fix(cad): reposition motor mounting towers and adapter for 48mm motor + horn length with zero interference
    [assembly.py]
2026-08-18 fix(cad): cut open motor mounting tower posts and wide bay for direct bolt and screwdriver access
2026-08-18 feat(cad): remove cradle split-seam dovetail and boss for smooth continuous cradle trough
2026-08-18 feat(cad): extend solid hinge base pedestal full length end-to-end for supportless FDM printing and rigid frame seating
2026-08-20 feat(hinge): implement captive inner-flanged shoulder pin and modular drop-in flap architecture
2026-08-20 feat(pin): convert end pivot pin and hex drive coupler to 100% solid parts
2026-08-20 fix(flap): implement full 360-degree cylindrical axle spine to fully enclose hex sockets
2026-08-20 fix(frame): eliminate corner fillet notch on knuckle barrel and add 360-degree knuckle rim chamfers
2026-08-20 fix(frame): confine knuckle outer rim chamfers strictly to cylinder envelope to eliminate rail face cut seam
2026-08-21 docs: update CHANGELOG for v1.2.0 captive-flanged-end-pin release
2026-08-21 feat(cad): extend follower and motorized flaps to full square (219x219.5mm) covering chassis rails
2026-08-21 fix(cad): eliminate flat chord facet and texture cuts on flap hinge cylinder for 100% smooth 360-degree cylindrical spine
2026-08-21 docs: update CHANGELOG for smooth flap cylinder release
2026-08-21 feat(cad): add 180-degree flap folding kinematic clearance to follower and motorized frames
2026-08-21 fix(cad): resolve corner fillet cutter bounding box artifact on frame and flap rails
2026-08-21 fix(cad): resolve bore chamfer inversion and ensure continuous adapter pocket clearance
2026-08-21 fix(cad): increase servo adapter hex peg length to 18mm for 8mm flap socket engagement
2026-08-21 docs(changelog): record 180-deg clearance, corner bounds, and servo adapter engagement fixes
2026-08-21 feat(adapter): standardize on solid continuous full-hex peg for unobstructed screw access and torsional strength
2026-08-21 fix(frame): reduce motorized frame wire conduit to fitted 10x8.6mm filleted port
2026-08-21 fix(frame,cover): eliminate 0.2mm thin lip artifact and align cover flush with outer chassis wall
2026-08-22 feat(frame,cover): implement 50/50 left wall split with 3.1mm solid outer wall and 60.8mm captive cap
2026-08-22 chore(print): update Bambu Lab 3MF project to fabrica-bambu-lab-256.3mf for 256x256mm build volume
    [fabrica-bambu-lab-256.3mf, fabrica-bambu-lab.3mf]
2026-08-22 docs(roadmap): update Phase 5 interface module & enclosure specs for 4 buttons, status LED, and PCA9685 + Pico/ESP32 dual-board housing
2026-08-22 docs(roadmap): lock Phase 5 enclosure hardware to ESP32 and PCA9685 boards with 4 buttons and status LED
2026-08-22 docs: standardize all project specifications on PCA9685 and ESP32 dual circuit boards
2026-08-22 docs(roadmap,params): specify 16mm button holes for Phase 5 interface deck
2026-08-22 docs(spec): create Phase 5 interface module & electronics enclosure feature spec
2026-08-22 docs(spec): integrate verified internet PCB dimensions and screw spacing for PCA9685 and WROOM-32/ESP-32S
2026-08-22 docs(spec): add dovetail joint attachment requirements for interface module casing
2026-08-22 feat(interface-module): implement Phase 5 controller case, interface panel, and assembly with 0.000 interference
    [interface_panel.py]
2026-08-22 feat(interface-module): add Power Distribution Board (PDB) standoffs, wiring saddles, and cooling slots
2026-08-22 fix(interface-case): ensure all 4 PDB standoffs have complete clearance and full pilot holes
    [interface_assembly.py, interface_case.py]
2026-08-22 feat(interface-case): add high-capacity 16-motor wire conduit and zero-tension strain-relief system
    [fabrica-bambu-lab-256.3mf]
2026-08-22 feat(interface-module): implement 4-sided screwless toolless snap-lock system
    [interface_case.py, interface_panel.py]
2026-08-22 feat(interface-panel): update status LED window to circular round aperture with top chamfer
2026-08-22 feat(interface-module): update interface enclosure to flat horizontal rectangular box geometry
2026-08-22 feat(interface-case): increase chassis height to 45.0mm for high-capacity wiring
2026-08-22 feat(interface-case): add 16 individual vertical motor wire slots with solid structural pillars
2026-08-22 feat(interface-case): extend 16 vertical motor slots to full height and close rear dovetails
2026-08-22 feat(interface): replace internal retention bosses with direct wall windows and matching panel snap tabs
    [interface_case.py, interface_panel.py]
2026-08-22 feat(interface-case): remove all internal wire traps, saddles, and snubber posts for clean floor
2026-08-22 feat(interface-case): remove redundant pry-notches for 100% continuous flush top rim
2026-08-22 feat(interface-case): add modular sliding dovetail joint socket at X=55mm to connect to any robot base frame
2026-08-22 feat(interface-case): integrate external male sliding dovetail key directly on rear wall with 100% solid inner wall
2026-08-22 feat(interface-case): add 6.8x8.6mm internal wire raceway through integrated dovetail arm
2026-08-22 feat(interface-case): adjust slot height to 25mm to create 8mm solid header beam below snap window
    [interface_case.py]
2026-08-22 feat(interface-case): standardize motor wire slots to 4.0x16.0mm with 2.0mm pillars
2026-08-23 feat(interface-case): update motor wire slot pillars to 3.0mm width on 7.0mm pitch
2026-08-23 feat(interface-module): reduce case width to 140mm by arranging PDB vertically alongside ESP32 and PCA9685
2026-08-23 feat(interface-case): move integrated male dovetail to left end behind PDB
2026-08-23 feat(interface-panel): increase button pitch to 30mm for generous finger spacing
2026-08-23 feat(interface-module): add sleek R=8mm filleted vertical corners removing boxy edges
2026-08-23 chore(3d-print): update Bambu Lab 3MF project with latest interface module geometry
    [fabrica-bambu-lab-256.3mf]
2026-08-24 docs(roadmap): mark full assembly as completed and update firmware requirements
2026-08-27 feat(firmware): implement Phase 2 UI subsystem with 4-button debouncer and non-blocking LED engine
2026-08-28 feat(firmware): implement Phase 3 I2C PCA9685 16-channel PWM servo driver
2026-08-28 refactor(firmware): migrate PCA9685 driver to ESP-IDF v5.2+ driver/i2c_master.h
2026-08-28 docs(changelog): update root CHANGELOG.md for Phase 3 completion and driver migration
2026-09-07 docs(specs): refine BLE mobile integration and stateless execution architecture
    - Update project and firmware mission specs to establish mobile app support over Bluetooth Low Energy (NimBLE GATT)
    - Remove Wi-Fi, WebSockets, and hardware current sensing from firmware specifications
    - Expand Phase 8-11 roadmap and tech-stack for Proof-of-Presence BLE security, 30s authorization window, and bond lifecycle
    - Define client-side stateless garment profile execution and packed binary wire format (__attribute__((packed))) for button routine synchronization
    - Defer AI garment vision recognition to future roadmap
2026-09-07 docs(firmware): update specifications for BLE execution, control, buttons, and LED modes
    - Define packed binary wire framing protocol on Control Point (FAB1)
    - Establish canonical FAB3 transport with active motion write locks
    - Specify integer motor jog calibration lifecycle and thermal cutoff
    - Define empty preset validation and execution completion notification
    - Add CMD_SET_LED_MODE with Stealth/Night mode and mobile UI style mapping
    - Document CRC32 computation boundaries and zero-padding rules
    - Update CHANGELOG.md with 2026-09-07 spec maintenance entries
2026-11-06 feat(firmware): align state machine and UI subsystem with BLE-centric architecture
    - Transition state machine from legacy visual staging to BLE pairing and mobile configuration
    - Add 120-second BLE pairing window (CMD_ENTER_BLE_PAIRING) triggered by 3-second button hold
    - Introduce CMD_SET_BUTTON_SEQUENCE and CMD_RESTORE_FACTORY_PRESETS for wireless preset sync
    - Standardize button gesture translation to Presets 1-4, BLE pairing hold, and mid-motion E-Stop
    - Scope IPC queue and event group primitives cleanly within main.c
    - Update unit and end-to-end stress tests with 100% test suite pass rate
    - Synchronize system specifications and firmware README documentation
2026-11-06 feat(firmware): update default presets to exercise all 4 flap motors including top collar
    - Add SERVO_FLAP_TOP (Channel 3) to factory default folding presets in storage.c
    - Update Preset 1 (Adult T-Shirt) to 4 steps (Ch 0 -> 1 -> 2 -> 3) for complete 4-motor hardware testing on Button 1
    - Update Preset 2 to 5 steps, Preset 3 to 3 steps, and Preset 4 to 4 steps to exercise top collar flap
    - Update test_storage, test_state_machine, and test_e2e_stress test suites
    - Verify 100% pass rate across all 7 test suites
2026-11-06 docs(specs): synchronize specifications and guides with latest design and 4-motor presets
    - Update firmware README and Phase 7 specs (requirements, plan, validation) with 4-motor factory presets
    - Synchronize tech-stack.md command enum and LED state table with canonical command.h and led.h
    - Update root mission.md marking firmware Phase 0-7 as complete with 566/566 tests passing
    - Update mobile-app/README.md with current BLE architecture capabilities
    - Fix absolute link paths in cad-designs/specs/roadmap.md and firmware/README.md
2026-11-06 chore(3d-print): update Bambu Studio 3MF project file
2026-11-06 feat(cad): track and export all STEP models and printable part STL files
    - Update .gitignore to allow cad-designs/exports while excluding oversized assembly STL meshes (*assembly.stl)
    - Add 16 production STEP models (17 MB total) for Bambu Studio and parametric CAD assemblies
    - Add 12 printable individual part STL files (67 MB total) for direct slicing (base, flaps, frames, joiners, interface)
2026-11-08 feat(firmware): Phase 9 BLE Command Dispatch, Remote Execution & Servo Calibration
2026-11-08 chore(3d-print): enable part support and update Bambu Lab 256 3MF settings
2026-11-12 feat(firmware): keep BLE pairing mode open indefinitely on zero bonds until first device pairs
