aiandrobotics/fabrica/(notices)

Notices in the files:
README.md:
License: MIT / Open Source
